hairymnstr/Z80-Project-Mark-2/doc/IMG00038-20100109-2210.jpg

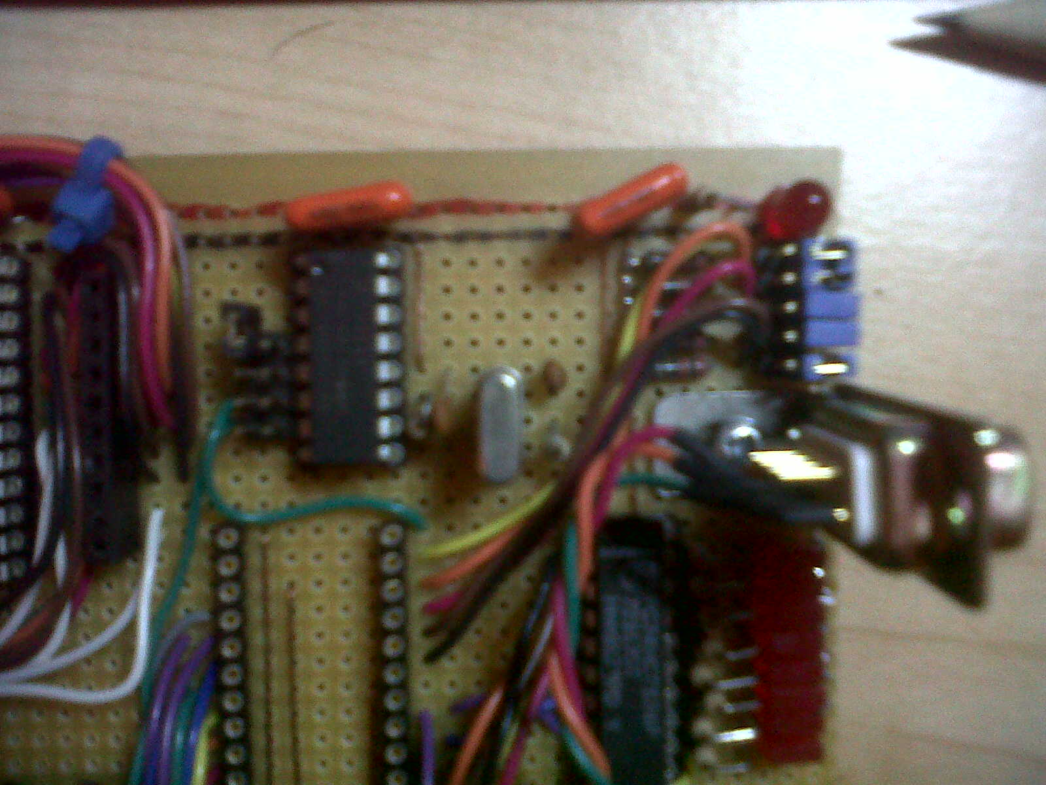
doc/IMG00038-20100109-2210.jpg
