hairymnstr/Z80-Project-Mark-2/doc/uart_jumpers.png

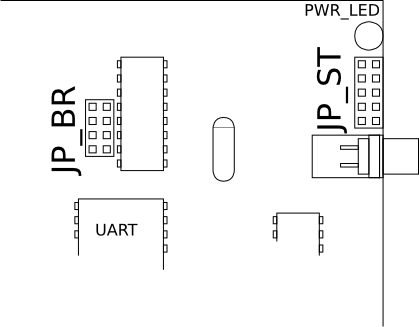
doc/uart_jumpers.png
