hairymnstr/Z80-Project-Mark-2/doc/pic_pinout.pdf

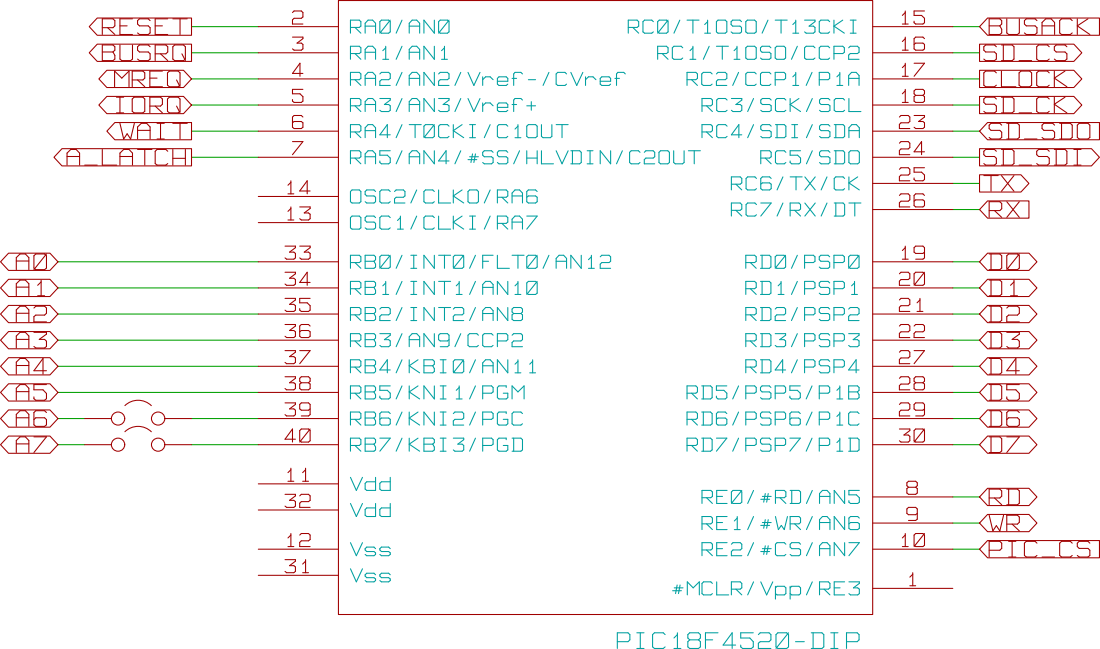
[picture p6: page 1]
