hairymnstr/Z80-Project-Mark-2/sch/z80_mark2-Interrupt Controller.pdf

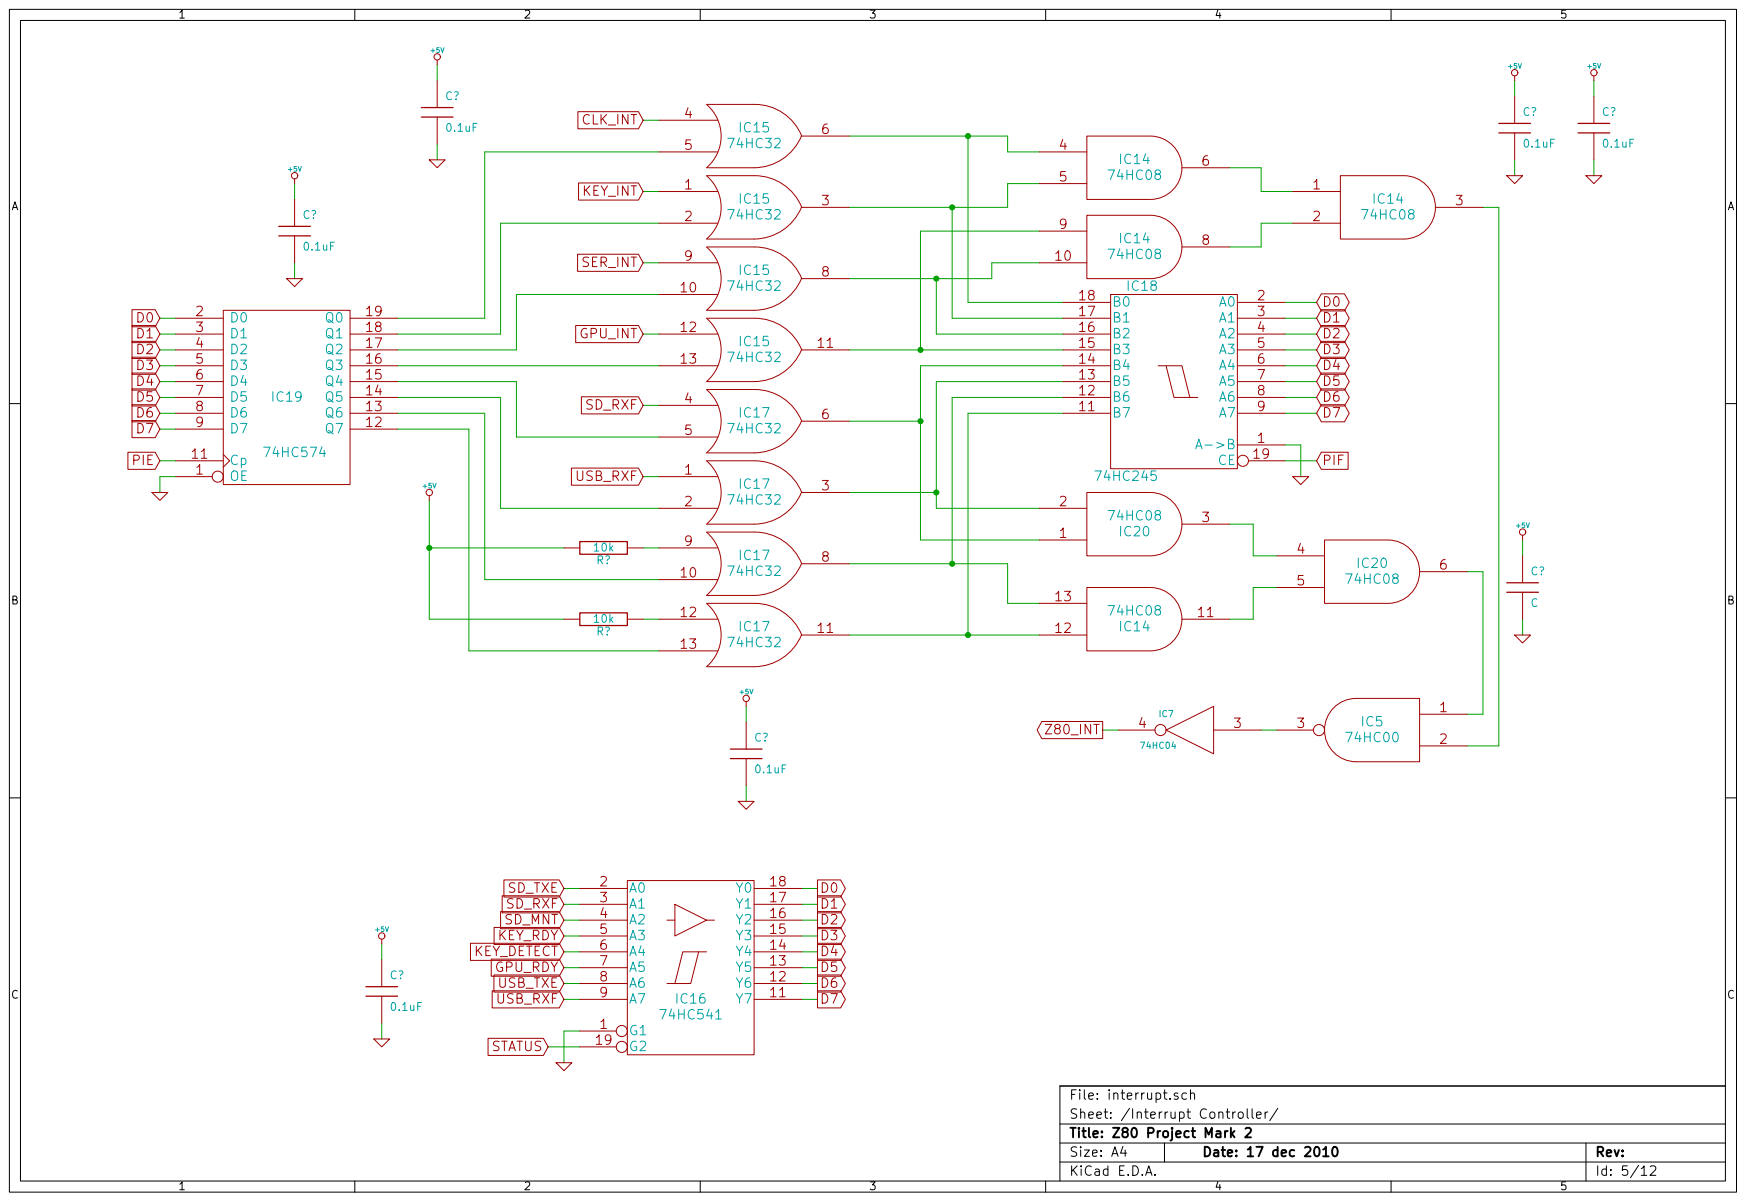
[picture p7: page 1]
