hairymnstr/Z80-Project-Mark-2/sch/z80_mark2-IO Decode.pdf

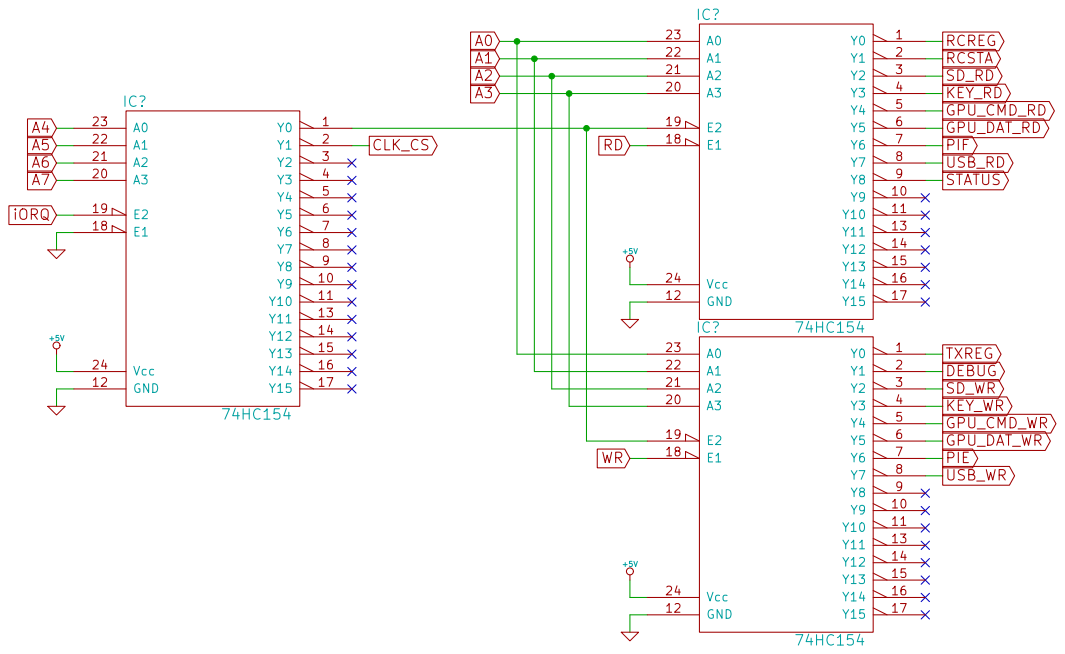
[picture p8: page 1]
