hairymnstr/Z80-Project-Mark-2/sch/z80_mark2-Keyboard PIC.pdf

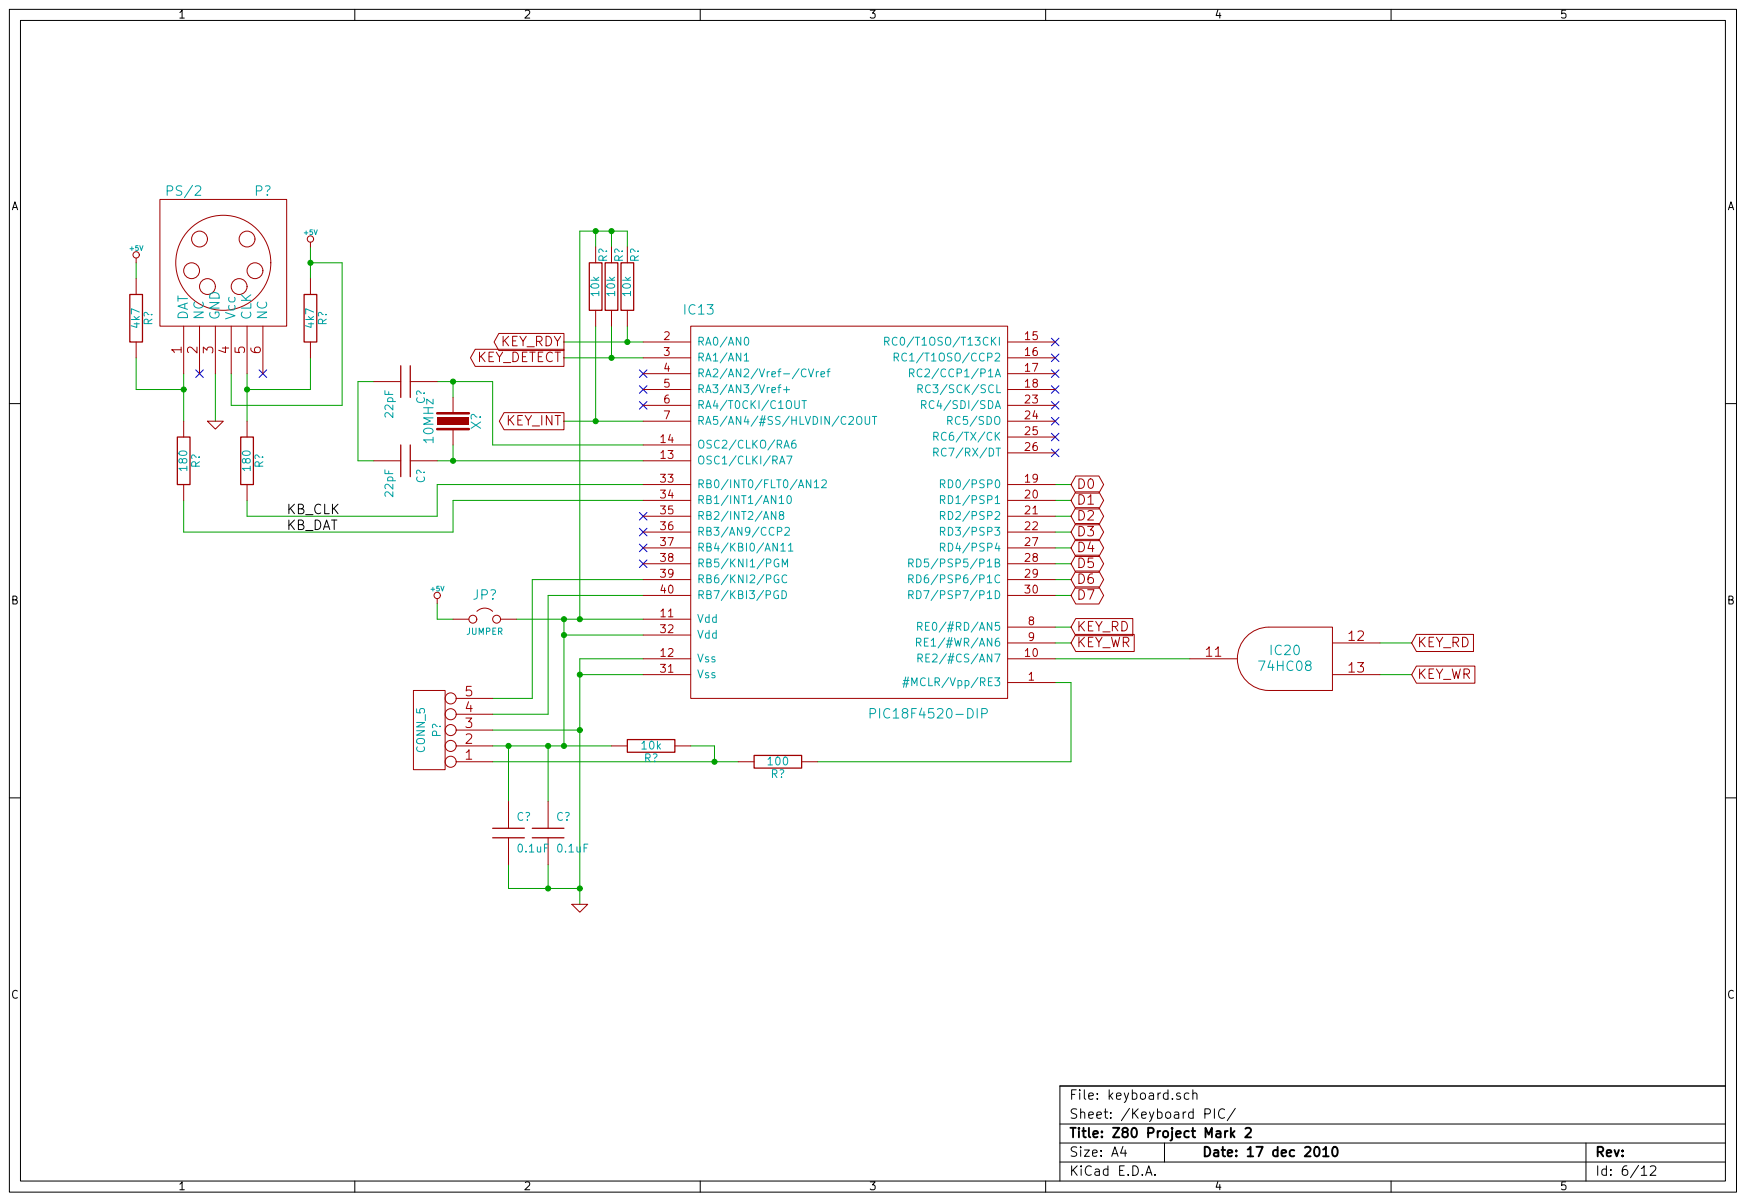
[picture p9: page 1]
