hairymnstr/Z80-Project-Mark-2/sch/z80_mark2-Master PIC.pdf

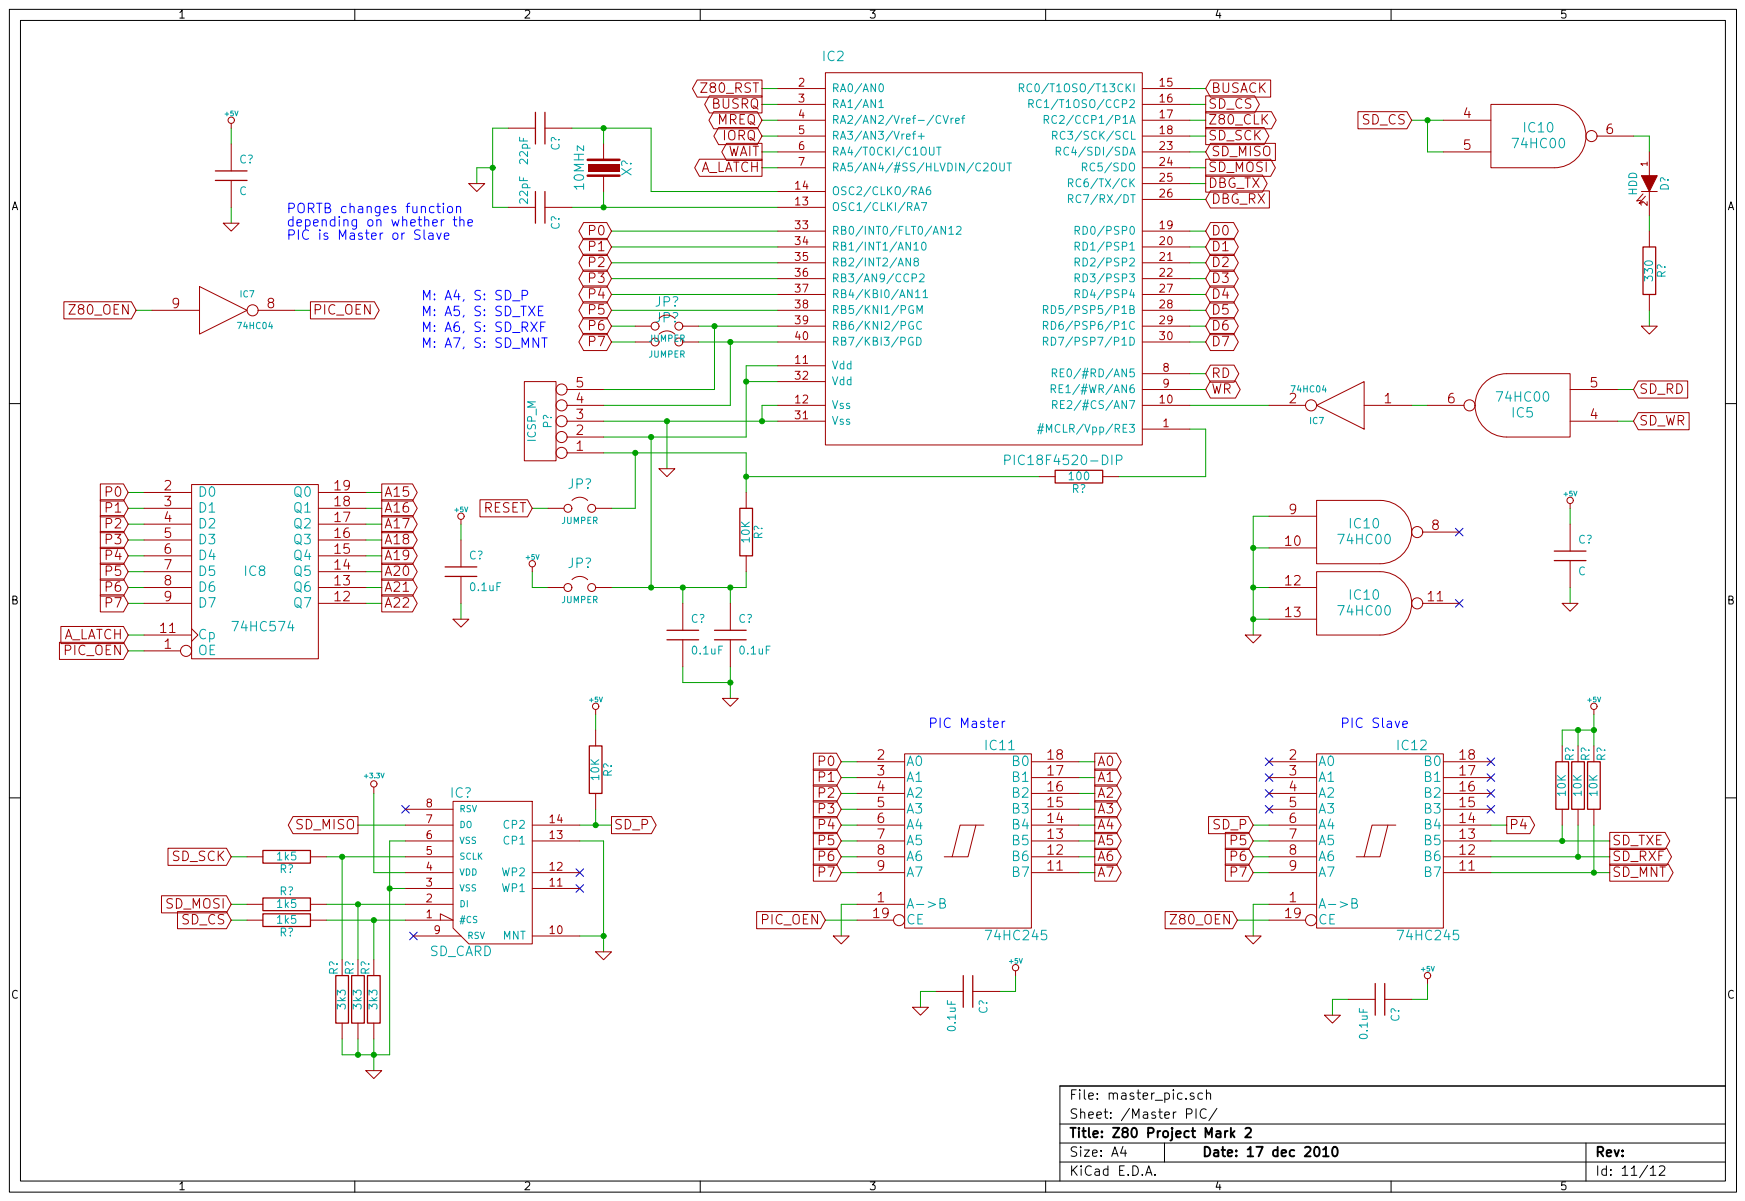
[picture p10: page 1]
