hairymnstr/Z80-Project-Mark-2/sch/z80_mark2-Memory.pdf

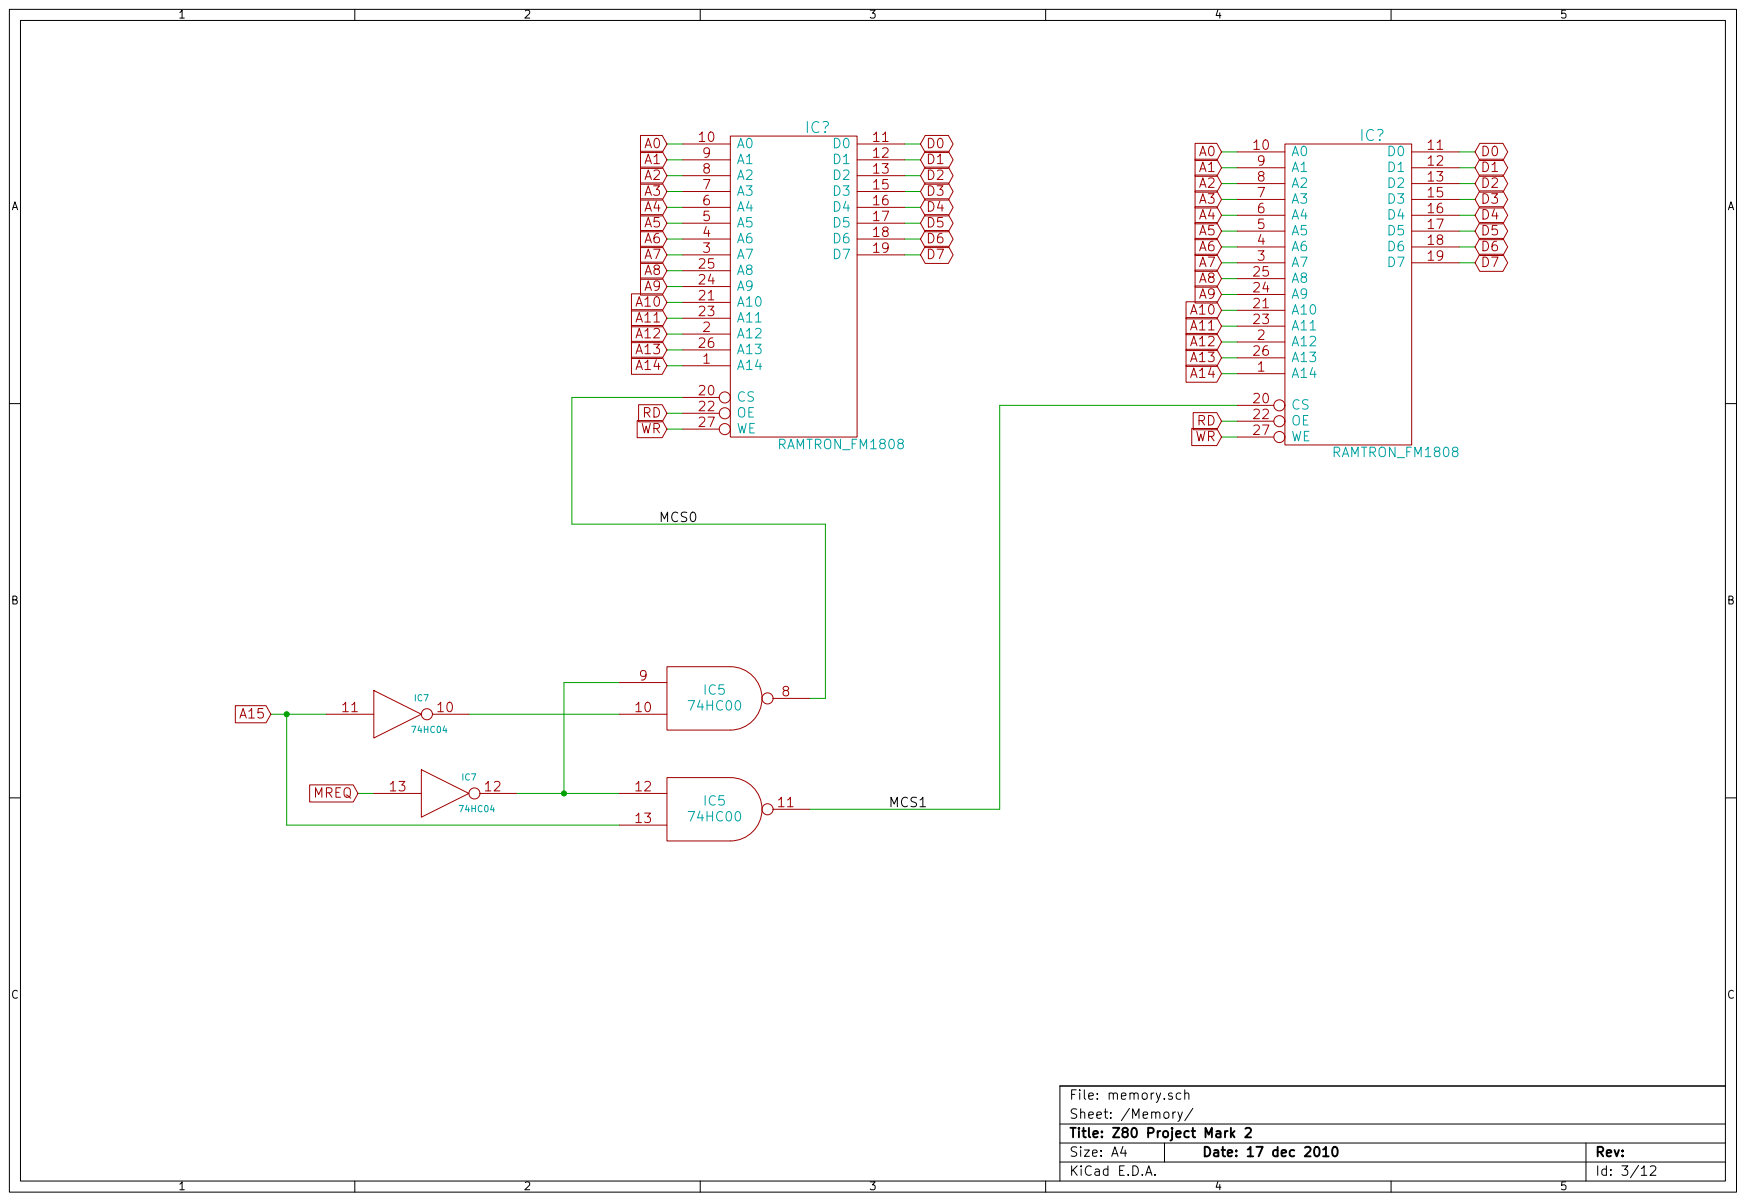
[picture p11: page 1]
