hairymnstr/Z80-Project-Mark-2/sch/z80_mark2-Memory2.pdf

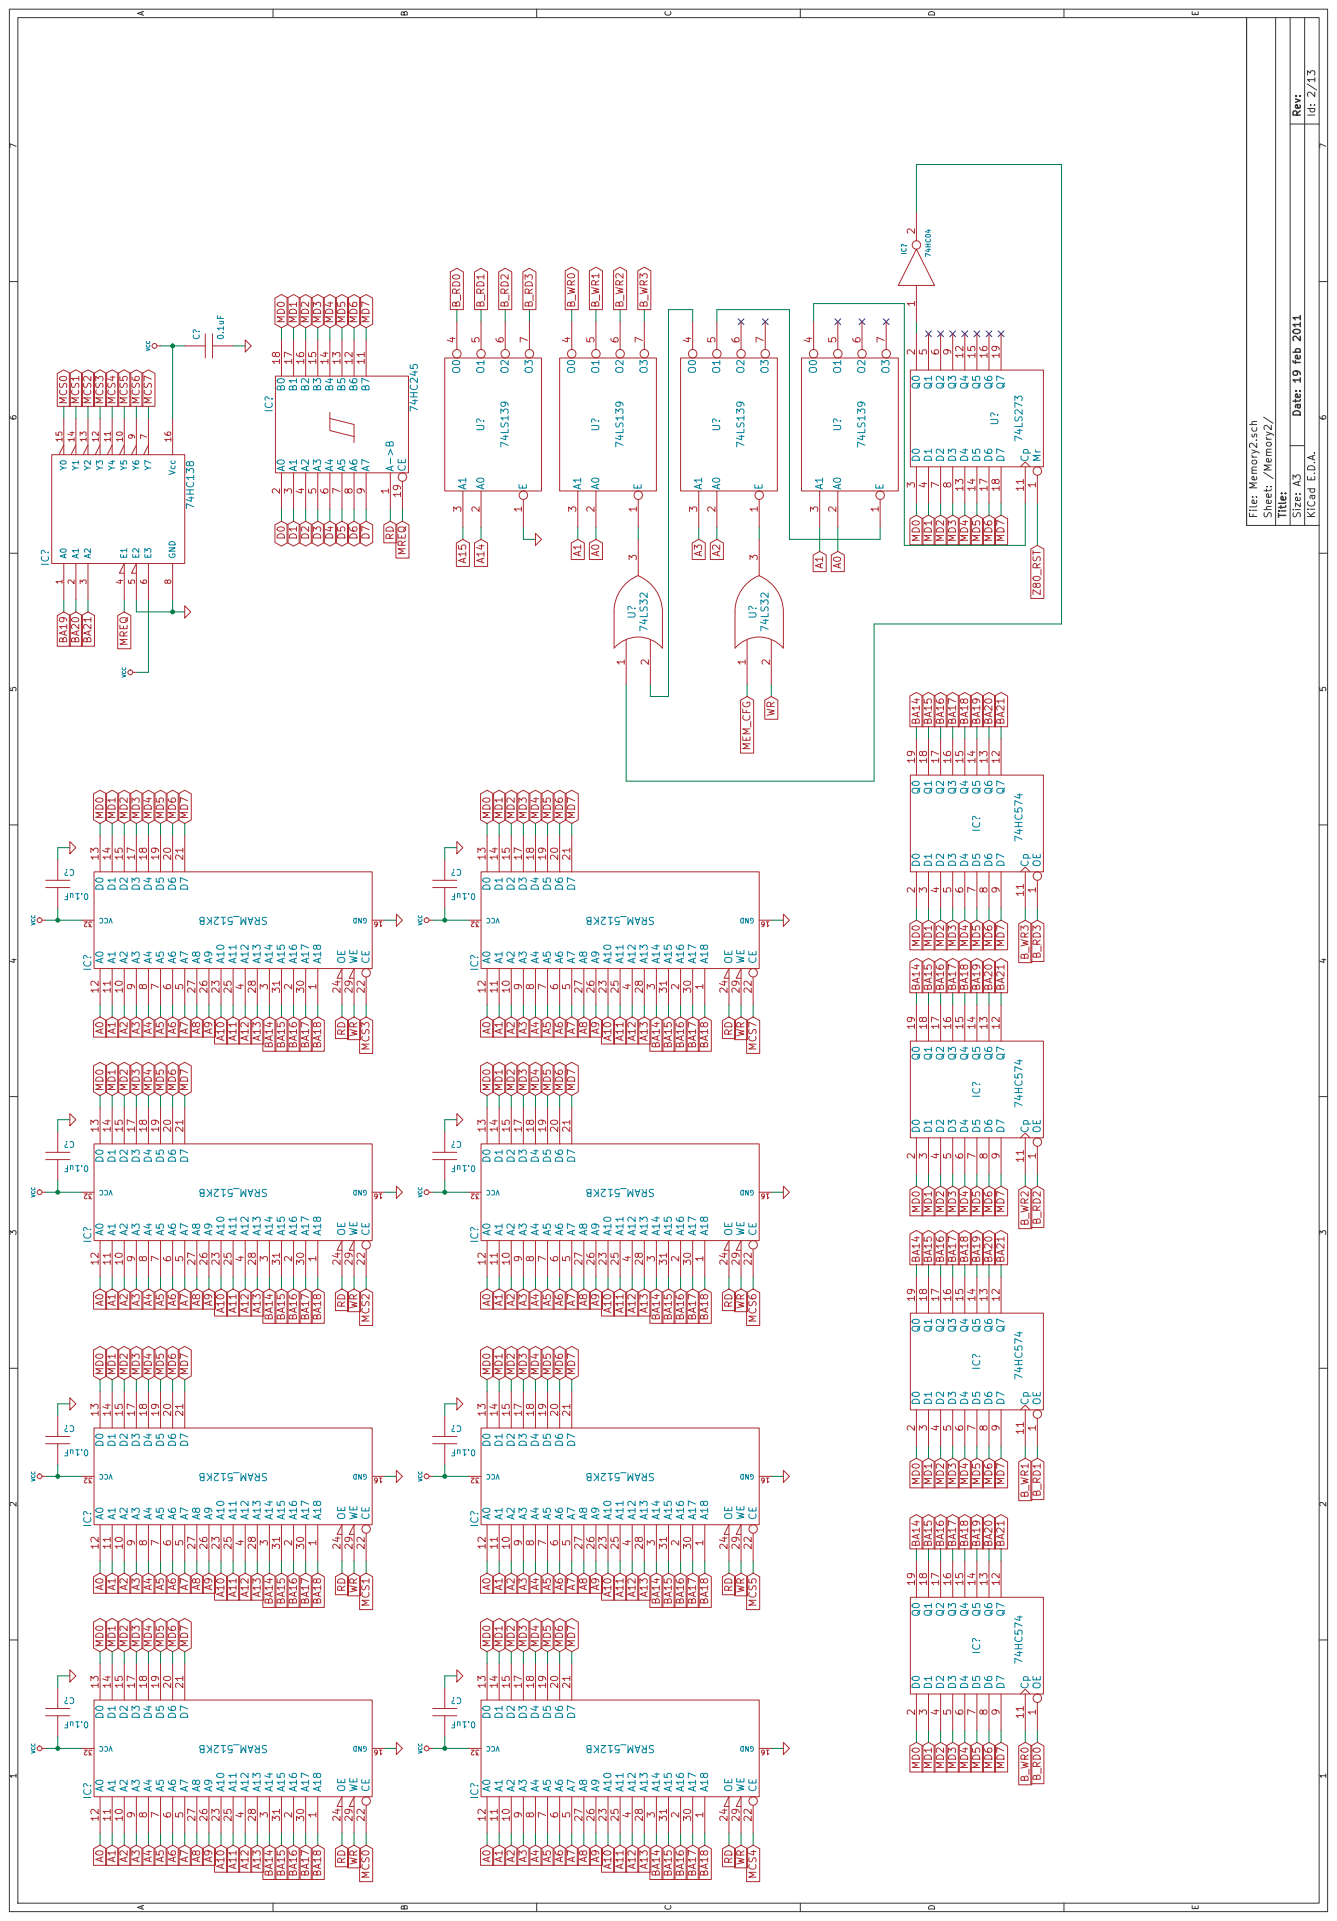
[picture p12: page 1]
