hairymnstr/Z80-Project-Mark-2/sch/z80_mark2-PSU.pdf

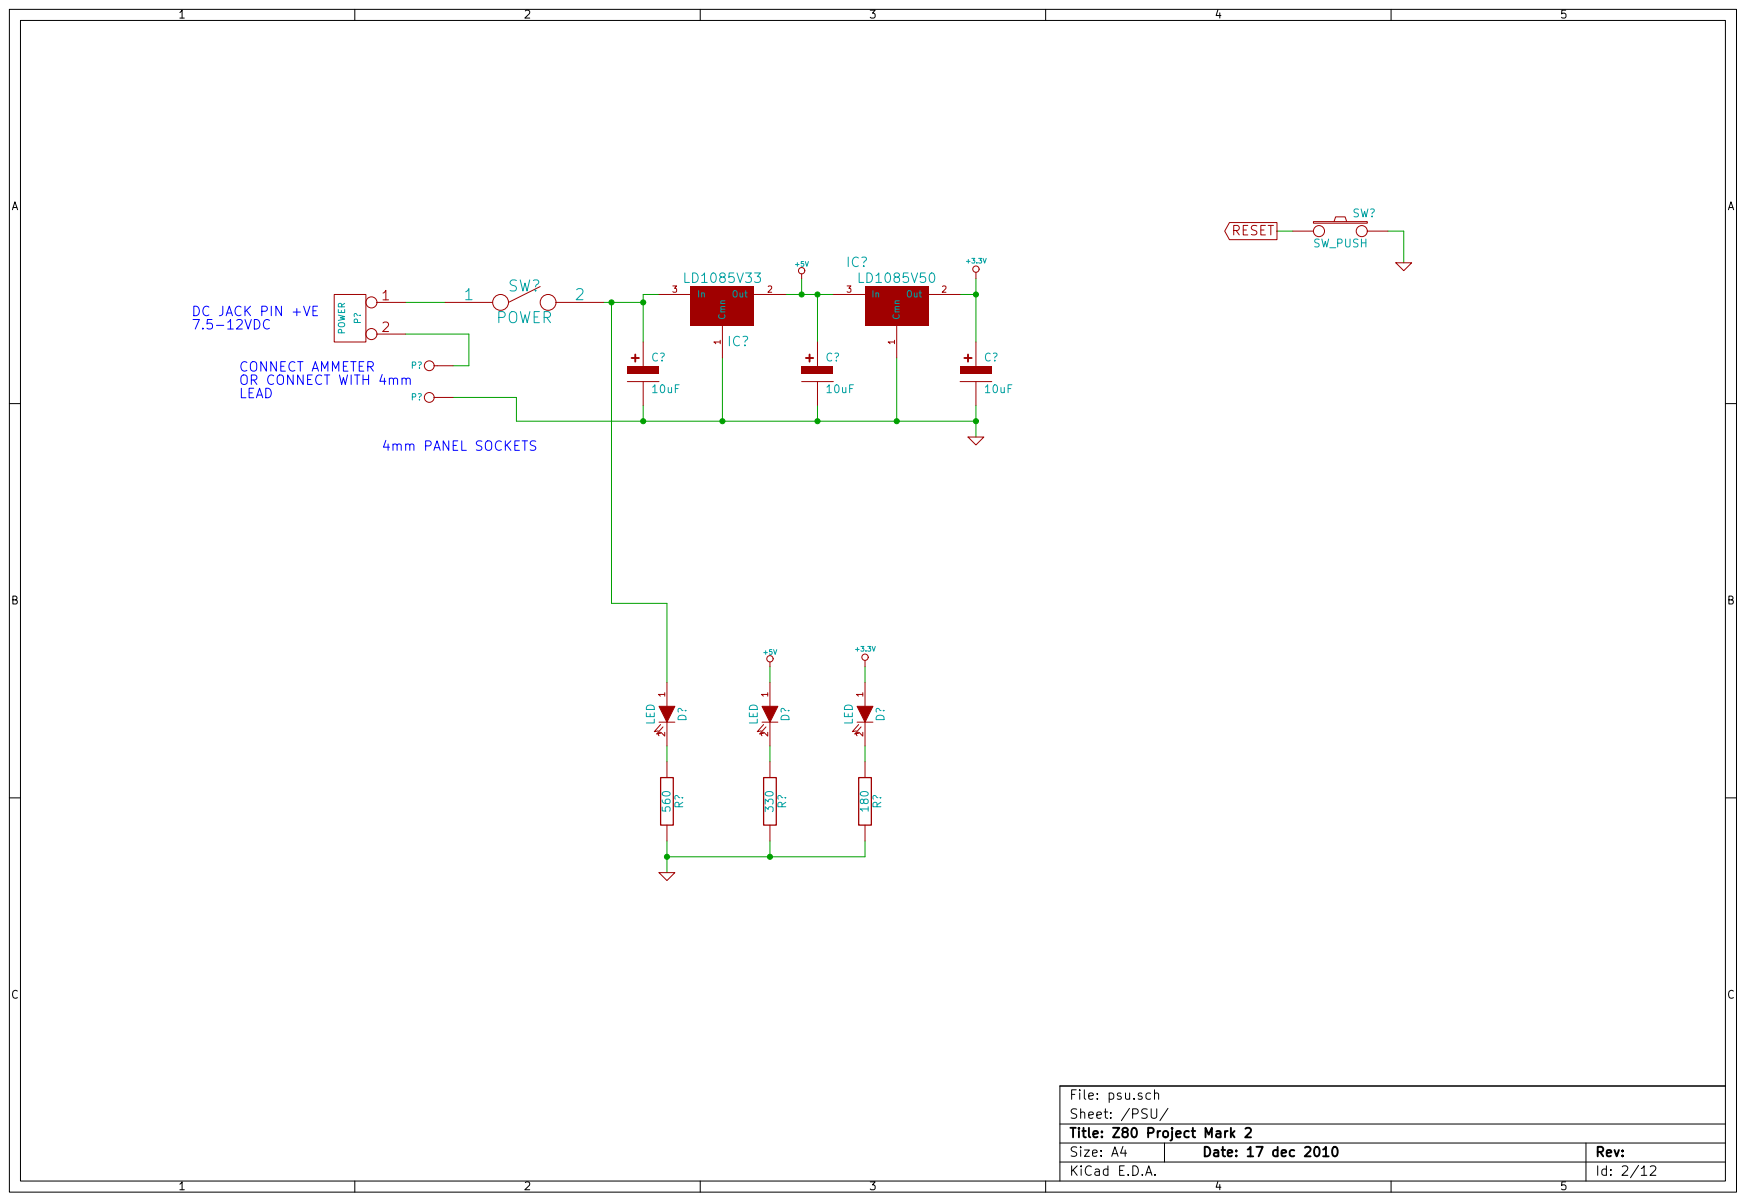
[picture p13: page 1]
