hairymnstr/Z80-Project-Mark-2/sch/z80_mark2-RTC.pdf

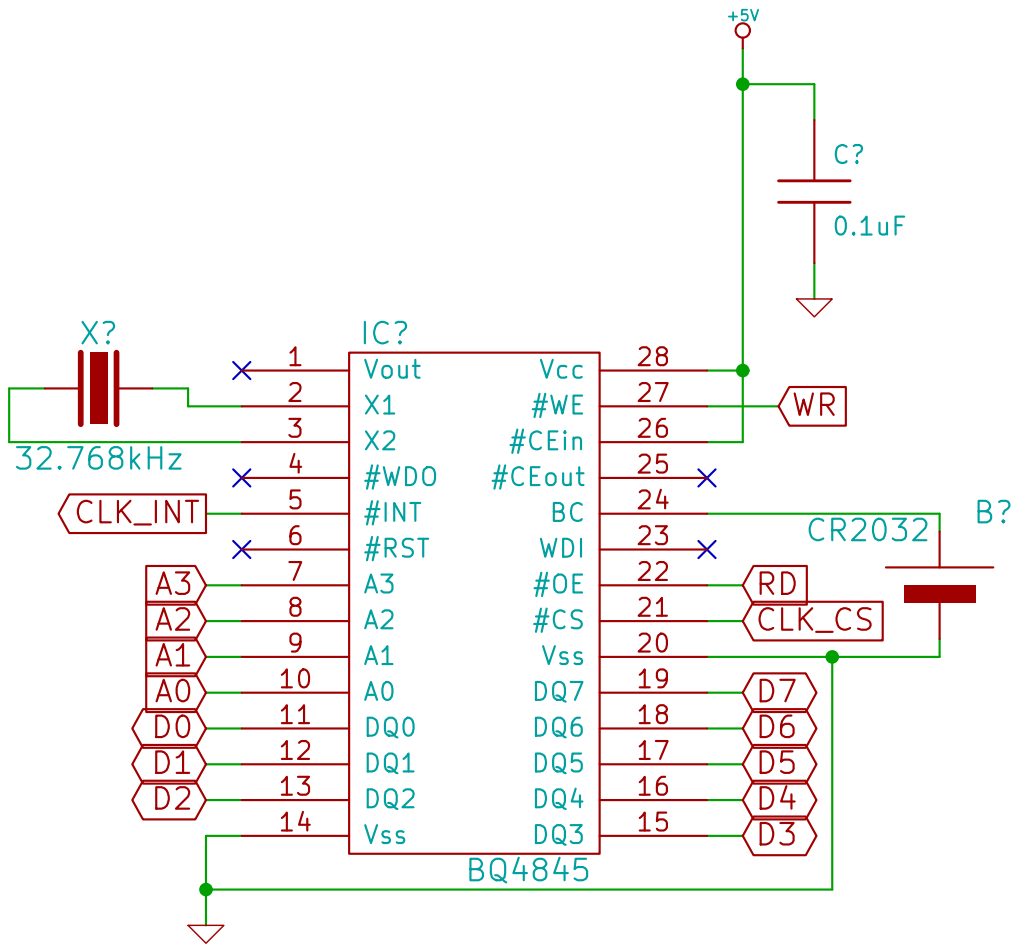
[picture p14: page 1]
