hairymnstr/Z80-Project-Mark-2/sch/z80_mark2-UART.pdf

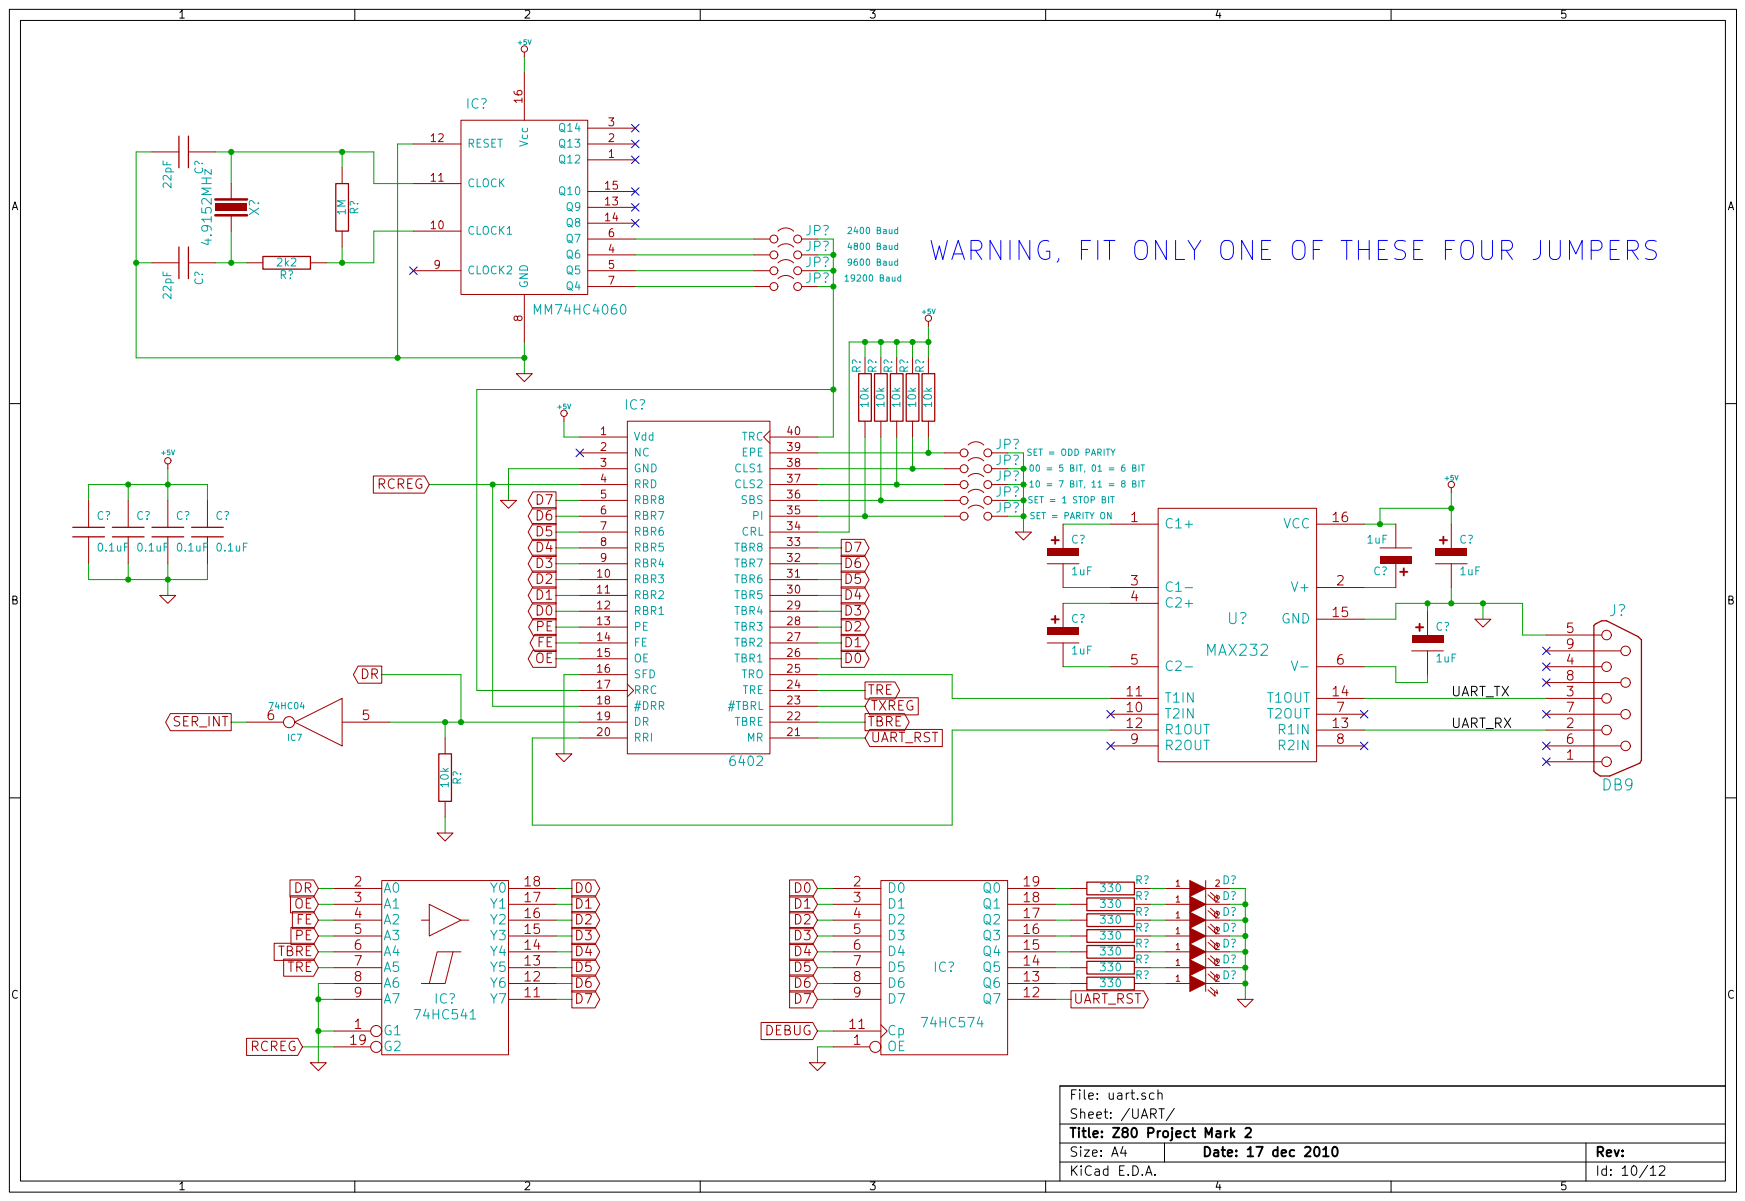
[picture p15: page 1]
