hairymnstr/Z80-Project-Mark-2/sch/z80_mark2-USB Host.pdf

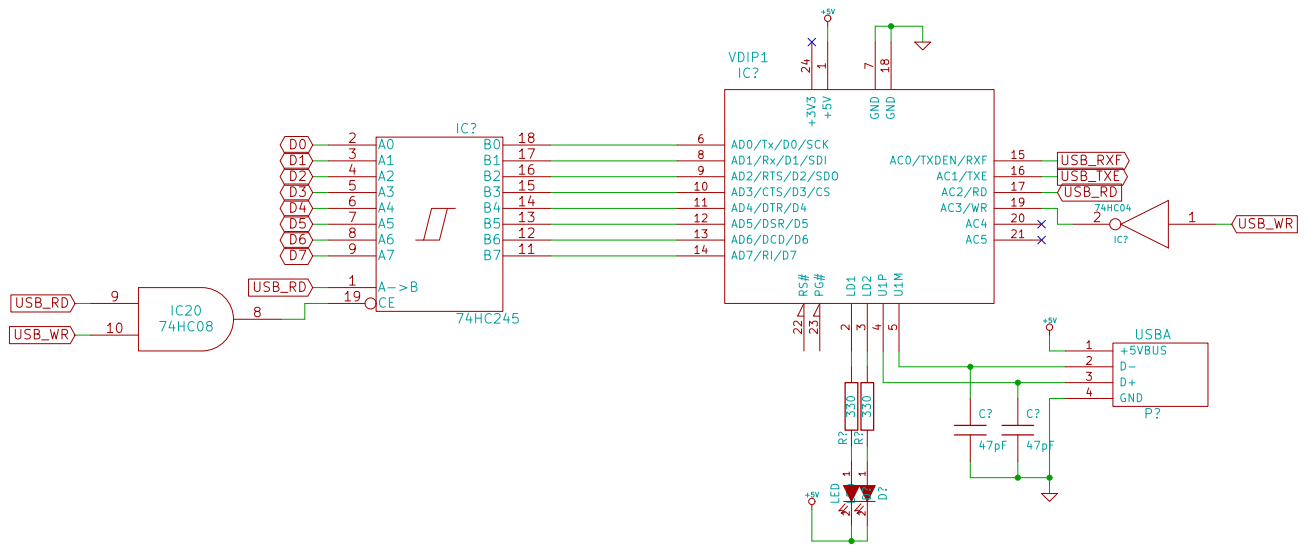
[picture p16: page 1]
