hairymnstr/Z80-Project-Mark-2/sch/z80_mark2-Video Driver.pdf

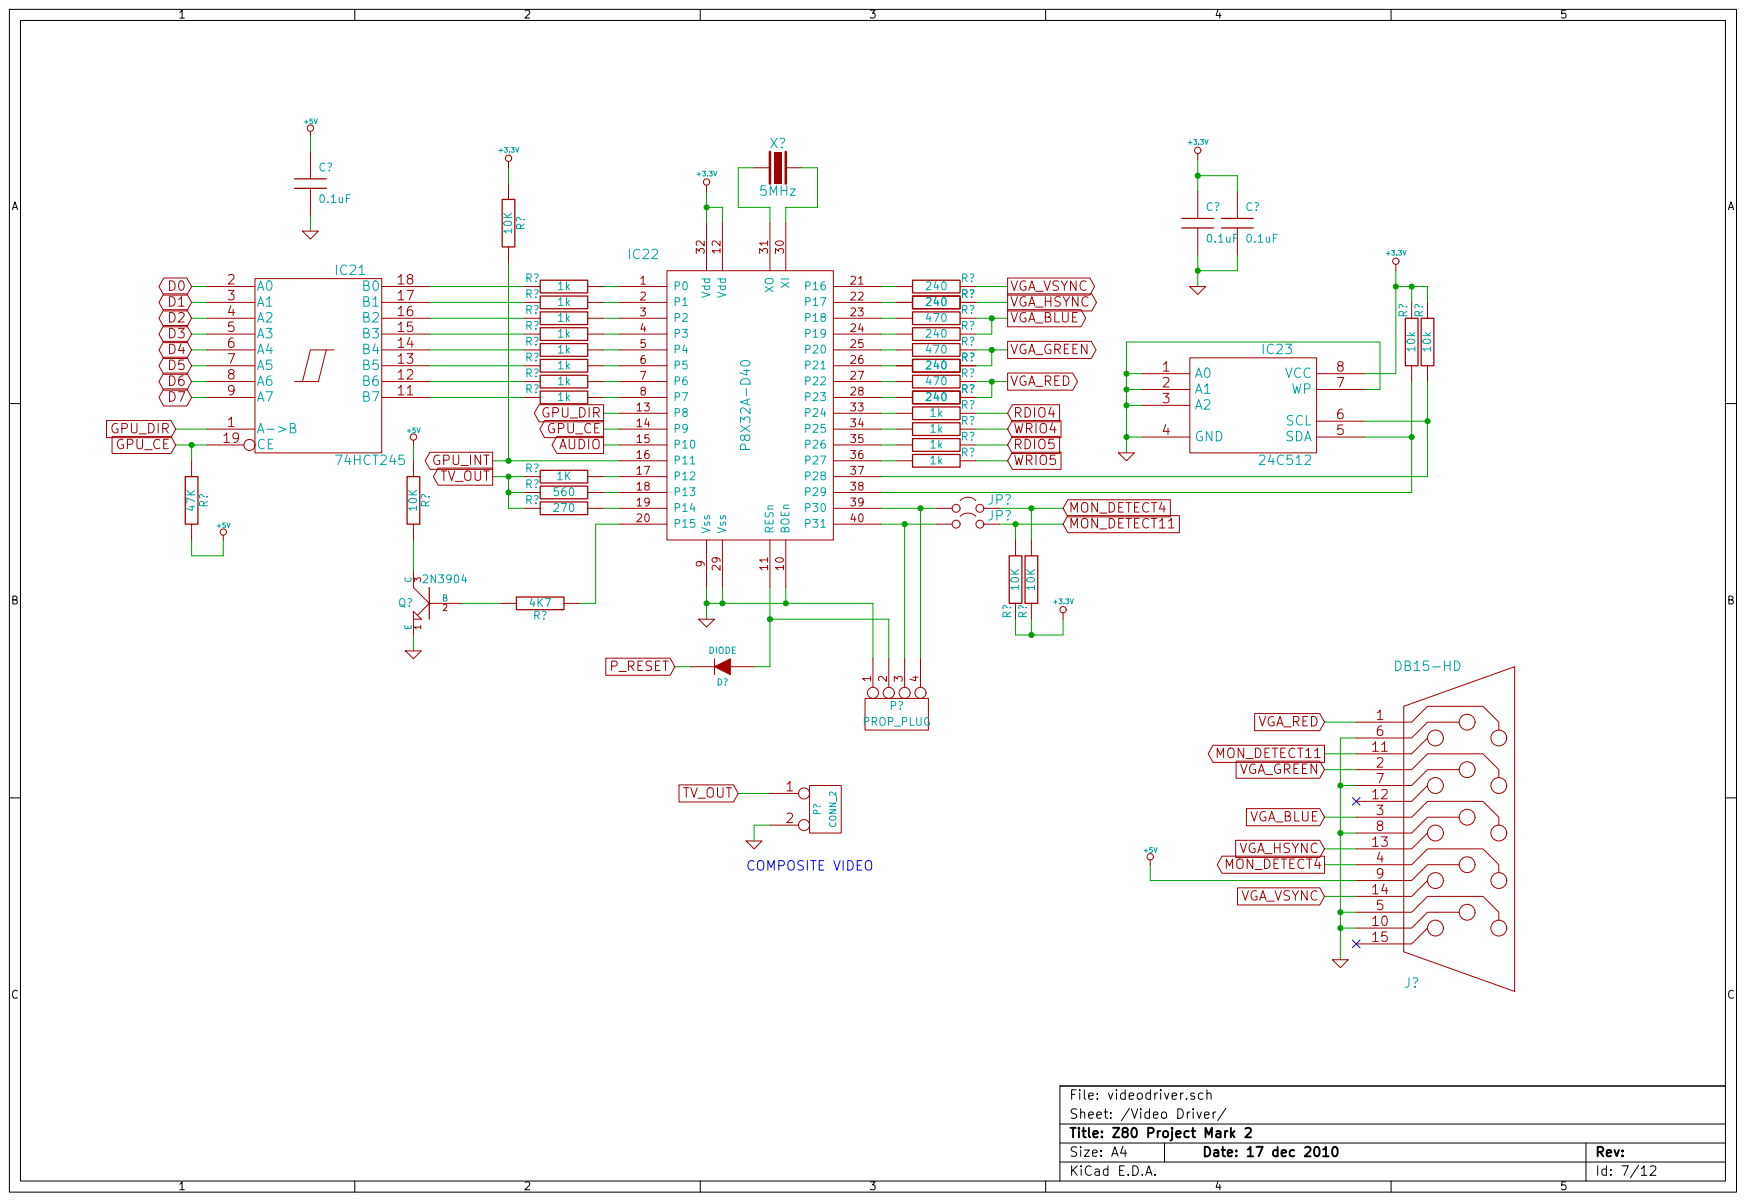
[picture p17: page 1]
