hairymnstr/Z80-Project-Mark-2/sch/z80_mark2-Z80.pdf

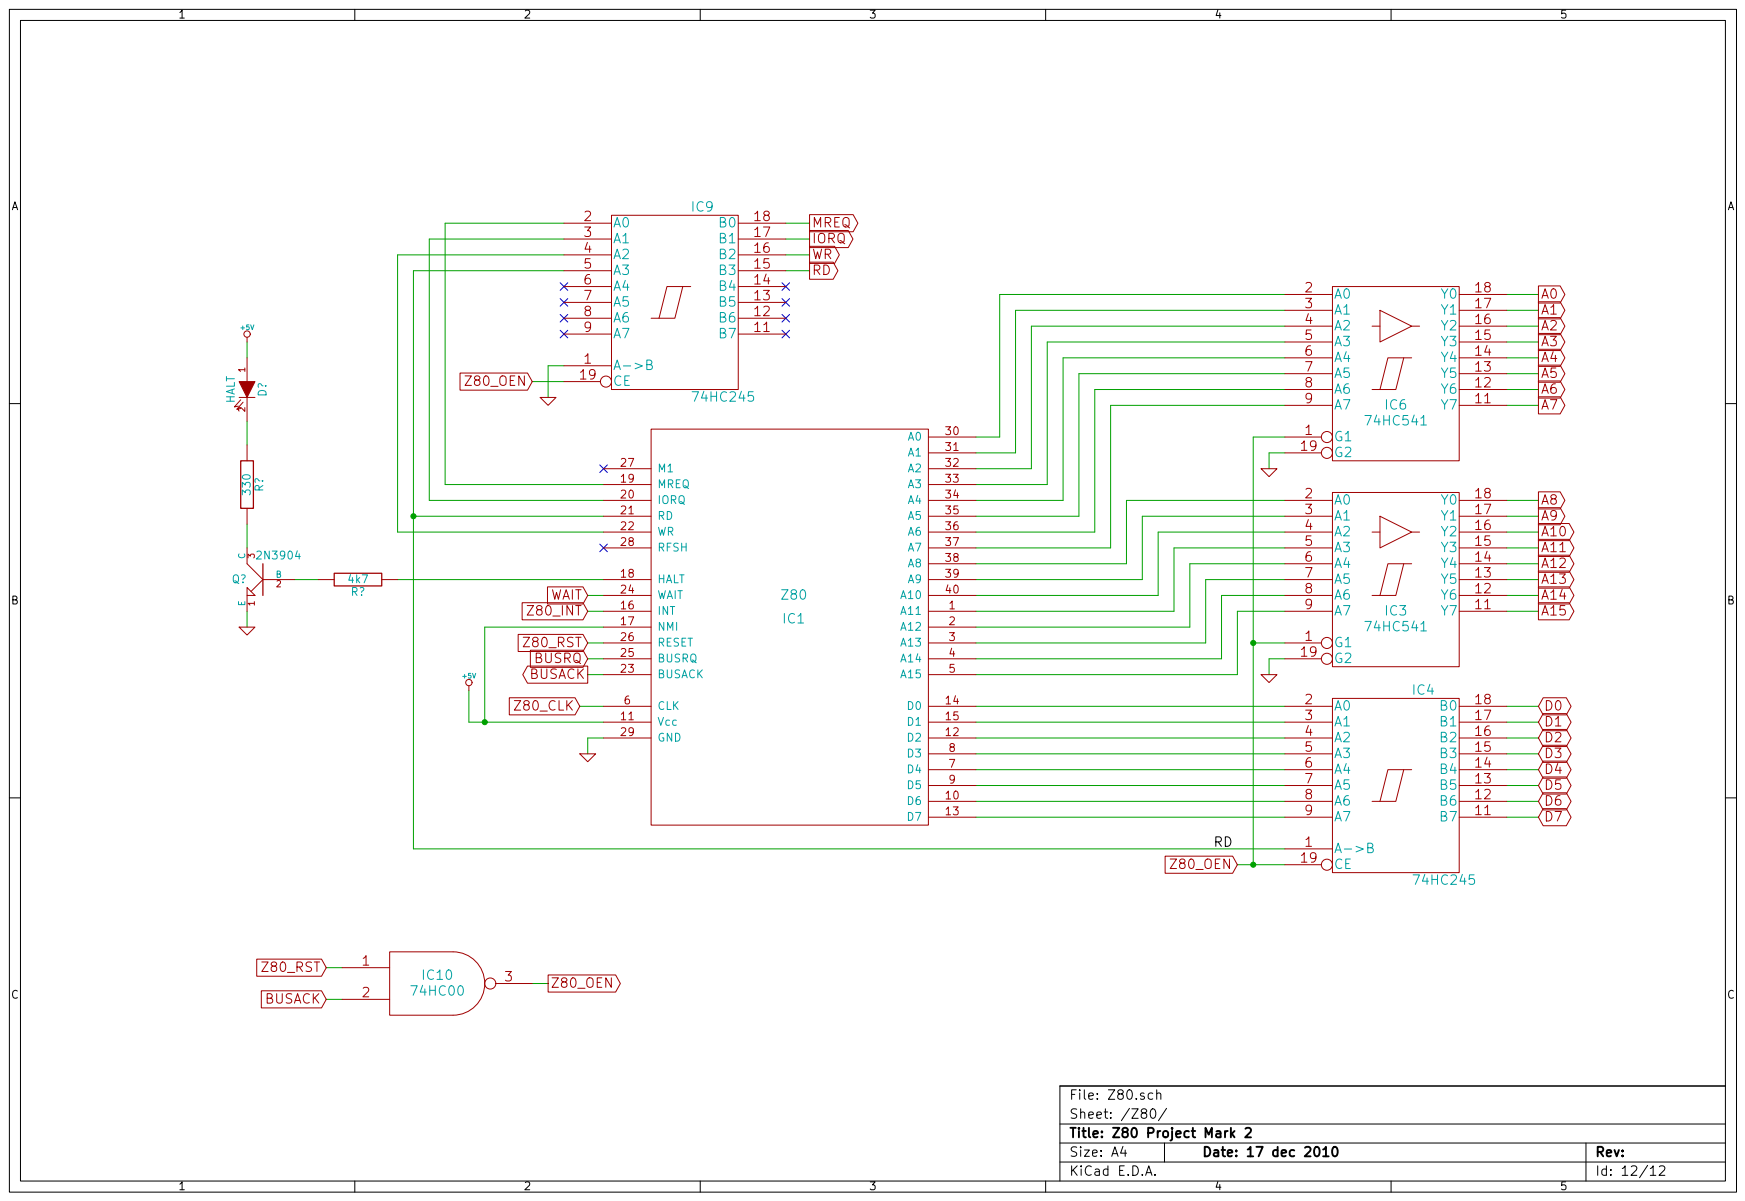
[picture p18: page 1]
