hairymnstr/Z80-Project-Mark-2/sch/z80_mark2.pdf

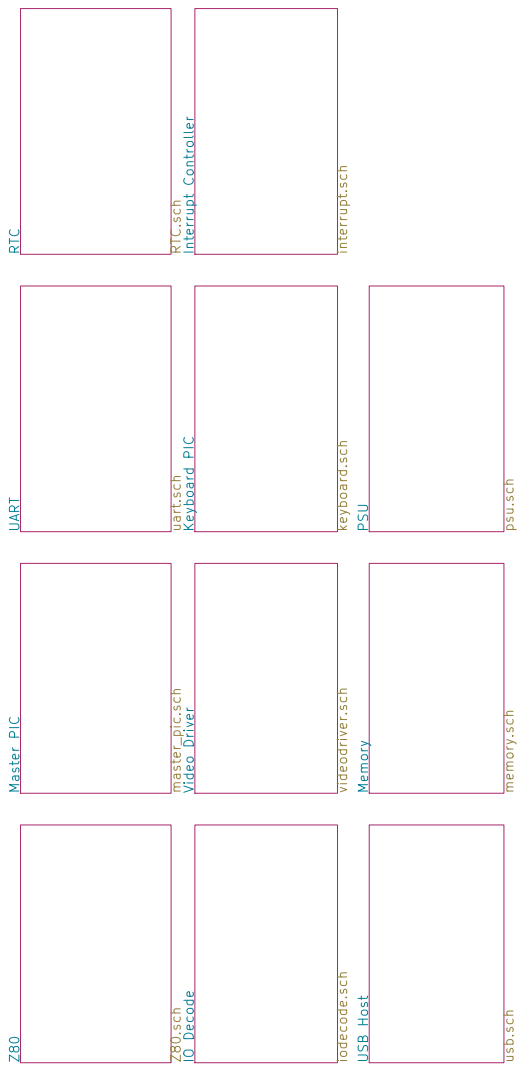
[picture p19: page 1]
