hairymnstr/Z80-Project-Mark-2/sch/Z80.sch

## KiCad design sch/Z80.sch (2011-03-06)

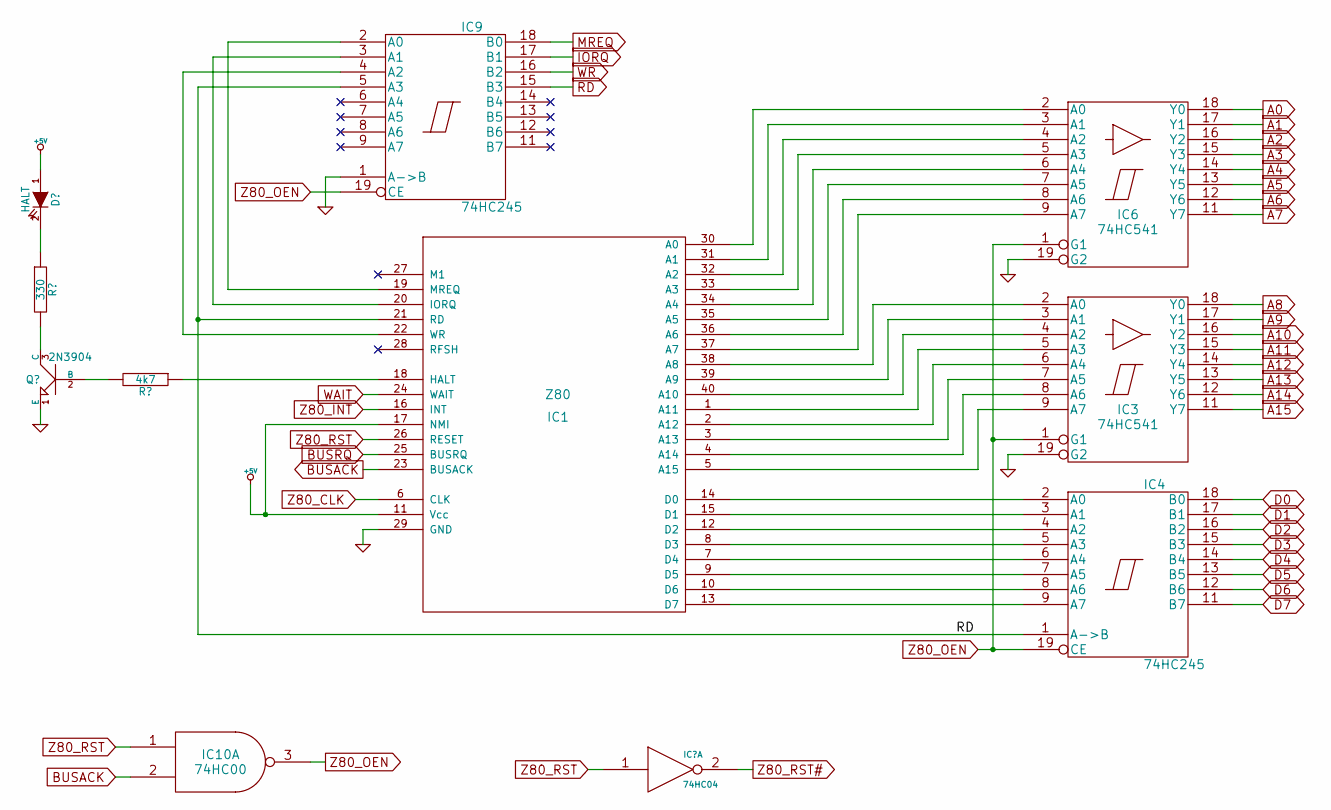
[picture p20: schematic Z80.sch]

Parts:
IC1: Z80
IC3, IC6: 74HC541; 108-5319
IC4, IC9: 74HC245; 108-5315
IC10: 74HC00

Connections:
+5V: IC1.11 (Vcc), IC1.17 (NMI)
A0: IC6.18 (Y0)
A1: IC6.17 (Y1)
A2: IC6.16 (Y2)
A3: IC6.15 (Y3)
A4: IC6.14 (Y4)
A5: IC6.13 (Y5)
A6: IC6.12 (Y6)
A7: IC6.11 (Y7)
A8: IC3.18 (Y0)
A9: IC3.17 (Y1)
A10: IC3.16 (Y2)
A11: IC3.15 (Y3)
A12: IC3.14 (Y4)
A13: IC3.13 (Y5)
A14: IC3.12 (Y6)
A15: IC3.11 (Y7)
BUSACK: IC1.23 (BUSACK), IC10.2
BUSRQ: IC1.25 (BUSRQ)
D0: IC4.18 (B0)
D1: IC4.17 (B1)
D2: IC4.16 (B2)
D3: IC4.15 (B3)
D4: IC4.14 (B4)
D5: IC4.13 (B5)
D6: IC4.12 (B6)
D7: IC4.11 (B7)
GND: IC1.29 (GND), IC3.19 (G2), IC6.19 (G2), IC9.1 (A->B)
IORQ: IC9.17 (B1)
MREQ: IC9.18 (B0)
unnamed: IC1.1 (A11), IC3.5 (A3)
unnamed: IC1.2 (A12), IC3.6 (A4)
unnamed: IC1.3 (A13), IC3.7 (A5)
unnamed: IC1.4 (A14), IC3.8 (A6)
unnamed: IC1.5 (A15), IC3.9 (A7)
unnamed: IC1.7 (D4), IC4.6 (A4)
unnamed: IC1.8 (D3), IC4.5 (A3)
unnamed: IC1.9 (D5), IC4.7 (A5)
unnamed: IC1.10 (D6), IC4.8 (A6)
unnamed: IC1.12 (D2), IC4.4 (A2)
unnamed: IC1.13 (D7), IC4.9 (A7)
unnamed: IC1.14 (D0), IC4.2 (A0)
unnamed: IC1.15 (D1), IC4.3 (A1)
unnamed: IC1.19 (MREQ), IC9.2 (A0)
unnamed: IC1.20 (IORQ), IC9.3 (A1)
unnamed: IC1.22 (WR), IC9.4 (A2)
unnamed: IC1.30 (A0), IC6.2 (A0)
unnamed: IC1.31 (A1), IC6.3 (A1)
unnamed: IC1.32 (A2), IC6.4 (A2)
unnamed: IC1.33 (A3), IC6.5 (A3)
unnamed: IC1.34 (A4), IC6.6 (A4)
unnamed: IC1.35 (A5), IC6.7 (A5)
unnamed: IC1.36 (A6), IC6.8 (A6)
unnamed: IC1.37 (A7), IC6.9 (A7)
unnamed: IC1.38 (A8), IC3.2 (A0)
unnamed: IC1.39 (A9), IC3.3 (A1)
unnamed: IC1.40 (A10), IC3.4 (A2)
RD: IC1.21 (RD), IC4.1 (A->B), IC9.5 (A3), IC9.15 (B3)
WAIT: IC1.24 (WAIT)
WR: IC9.16 (B2)
Z80_CLK: IC1.6 (CLK)
Z80_INT: IC1.16 (INT)
Z80_OEN: IC3.1 (G1), IC4.19 (CE), IC6.1 (G1), IC9.19 (CE), IC10.3
Z80_RST: IC1.26 (RESET), IC10.1
