hairymnstr/Z80-Project-Mark-2/sch/interrupt.sch

## KiCad design sch/interrupt.sch (2011-03-06)

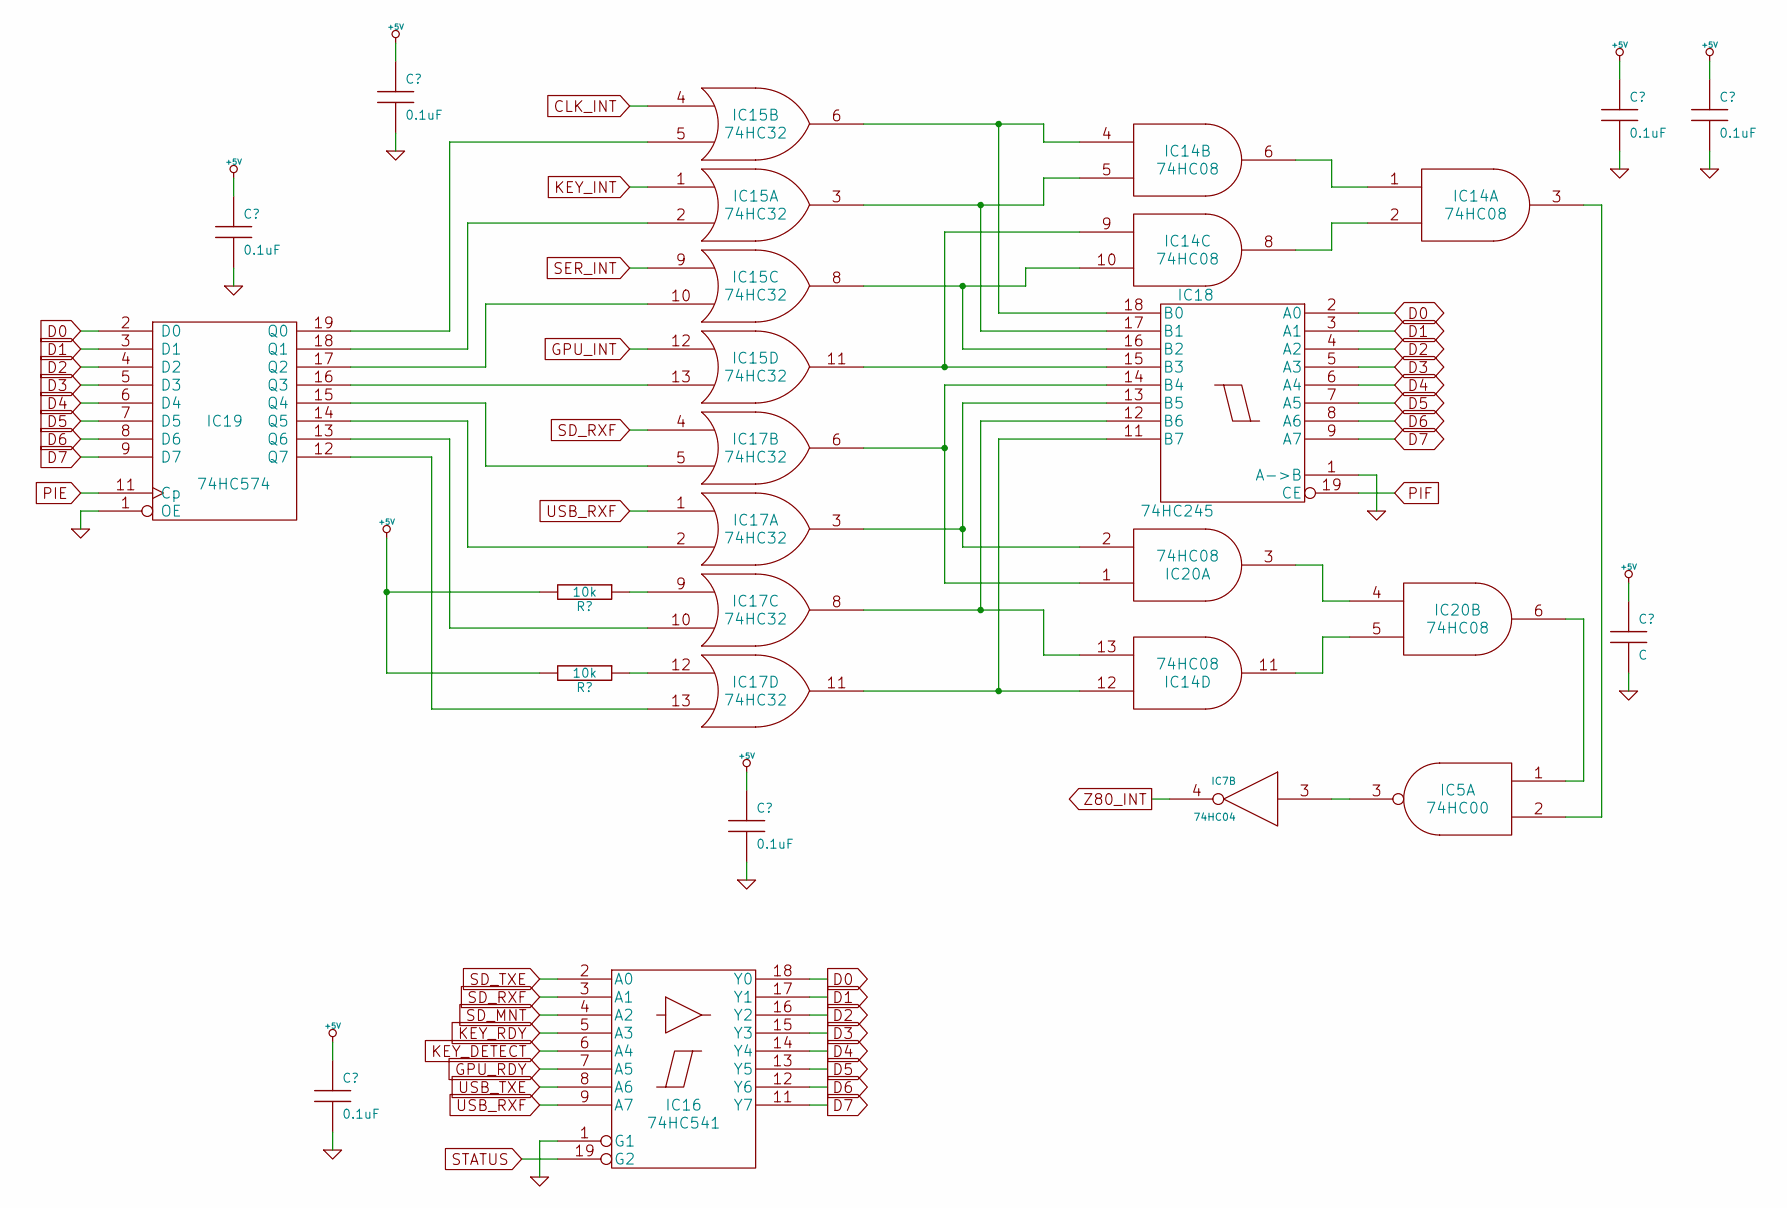
[picture p21: schematic interrupt.sch]

Parts:
IC5: 74HC00
IC7: 74HC04; 108-5299
IC14, IC20: 74HC08; 110-3129
IC15, IC17: 74HC32
IC16: 74HC541; 108-5319
IC18: 74HC245; 108-5315
IC19: 74HC574; 110-3146

Connections:
CLK_INT: IC15.4
D0: IC16.18 (Y0), IC18.2 (A0), IC19.2 (D0)
D1: IC16.17 (Y1), IC18.3 (A1), IC19.3 (D1)
D2: IC16.16 (Y2), IC18.4 (A2), IC19.4 (D2)
D3: IC16.15 (Y3), IC18.5 (A3), IC19.5 (D3)
D4: IC16.14 (Y4), IC18.6 (A4), IC19.6 (D4)
D5: IC16.13 (Y5), IC18.7 (A5), IC19.7 (D5)
D6: IC16.12 (Y6), IC18.8 (A6), IC19.8 (D6)
D7: IC16.11 (Y7), IC18.9 (A7), IC19.9 (D7)
GND: IC16.1 (G1), IC18.1 (A->B), IC19.1 (OE)
GPU_INT: IC15.12
GPU_RDY: IC16.7 (A5)
KEY_DETECT: IC16.6 (A4)
KEY_INT: IC15.1
KEY_RDY: IC16.5 (A3)
unnamed: IC5.3, IC7.3
unnamed: IC14.1, IC14.6
unnamed: IC14.2, IC14.8
unnamed: IC5.2, IC14.3
unnamed: IC14.4, IC15.6, IC18.18 (B0)
unnamed: IC14.5, IC15.3, IC18.17 (B1)
unnamed: IC14.9, IC15.11, IC18.15 (B3)
unnamed: IC14.10, IC15.8, IC18.16 (B2)
unnamed: IC14.11, IC20.5
unnamed: IC14.12, IC17.11, IC18.11 (B7)
unnamed: IC14.13, IC17.8, IC18.12 (B6)
unnamed: IC15.2, IC19.18 (Q1)
unnamed: IC15.5, IC19.19 (Q0)
unnamed: IC15.10, IC19.17 (Q2)
unnamed: IC15.13, IC19.16 (Q3)
unnamed: IC17.2, IC19.14 (Q5)
unnamed: IC17.3, IC18.13 (B5), IC20.2
unnamed: IC17.5, IC19.15 (Q4)
unnamed: IC17.6, IC18.14 (B4), IC20.1
unnamed: IC17.10, IC19.13 (Q6)
unnamed: IC17.13, IC19.12 (Q7)
unnamed: IC20.3, IC20.4
unnamed: IC5.1, IC20.6
PIE: IC19.11 (Cp)
PIF: IC18.19 (CE)
SD_MNT: IC16.4 (A2)
SD_RXF: IC16.3 (A1), IC17.4
SD_TXE: IC16.2 (A0)
SER_INT: IC15.9
STATUS: IC16.19 (G2)
USB_RXF: IC16.9 (A7), IC17.1
USB_TXE: IC16.8 (A6)
Z80_INT: IC7.4
