hairymnstr/Z80-Project-Mark-2/sch/keyboard.sch

## KiCad design sch/keyboard.sch (2011-03-06)

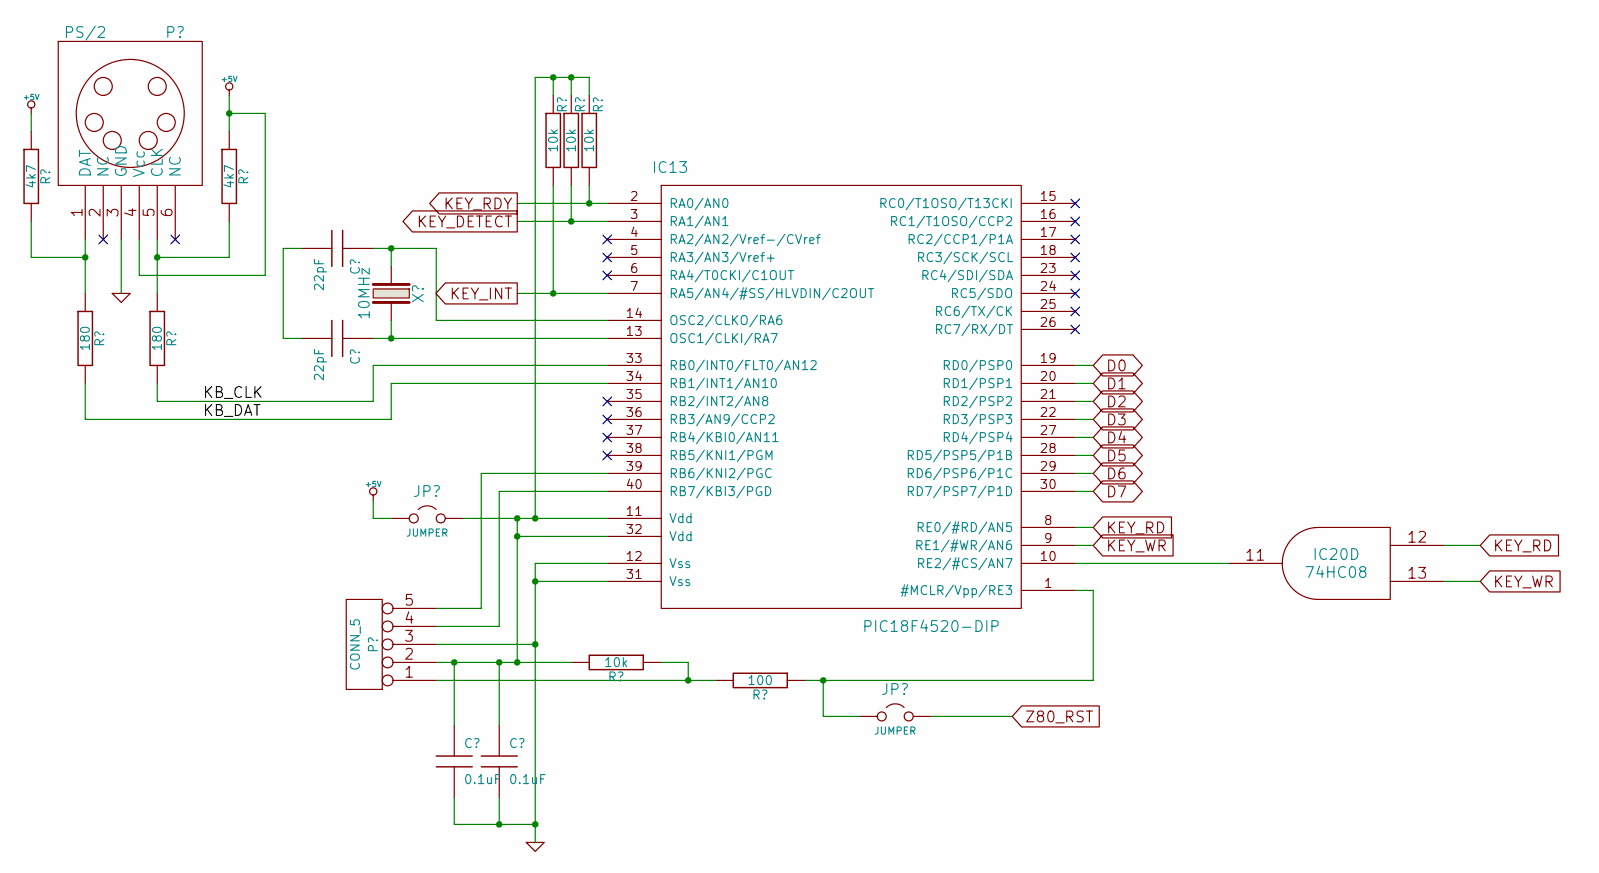
[picture p22: schematic keyboard.sch]

Parts:
IC13: PIC18F4520-DIP
IC20: 74HC08; 110-3129

Connections:
D0: IC13.19 (RD0/PSP0)
D1: IC13.20 (RD1/PSP1)
D2: IC13.21 (RD2/PSP2)
D3: IC13.22 (RD3/PSP3)
D4: IC13.27 (RD4/PSP4)
D5: IC13.28 (RD5/PSP5/P1B)
D6: IC13.29 (RD6/PSP6/P1C)
D7: IC13.30 (RD7/PSP7/P1D)
GND: IC13.12 (Vss), IC13.31 (Vss)
KB_CLK: IC13.33 (RB0/INT0/FLT0/AN12)
KB_DAT: IC13.34 (RB1/INT1/AN10)
KEY_DETECT: IC13.3 (RA1/AN1)
KEY_INT: IC13.7 (RA5/AN4/#SS/HLVDIN/C2OUT)
KEY_RD: IC13.8 (RE0/#RD/AN5), IC20.12
KEY_RDY: IC13.2 (RA0/AN0)
KEY_WR: IC13.9 (RE1/#WR/AN6), IC20.13
unnamed: IC13.10 (RE2/#CS/AN7), IC20.11
unnamed: IC13.11 (Vdd), IC13.32 (Vdd)
