hairymnstr/Z80-Project-Mark-2/sch/master_pic.sch

## KiCad design sch/master_pic.sch (2011-03-06)

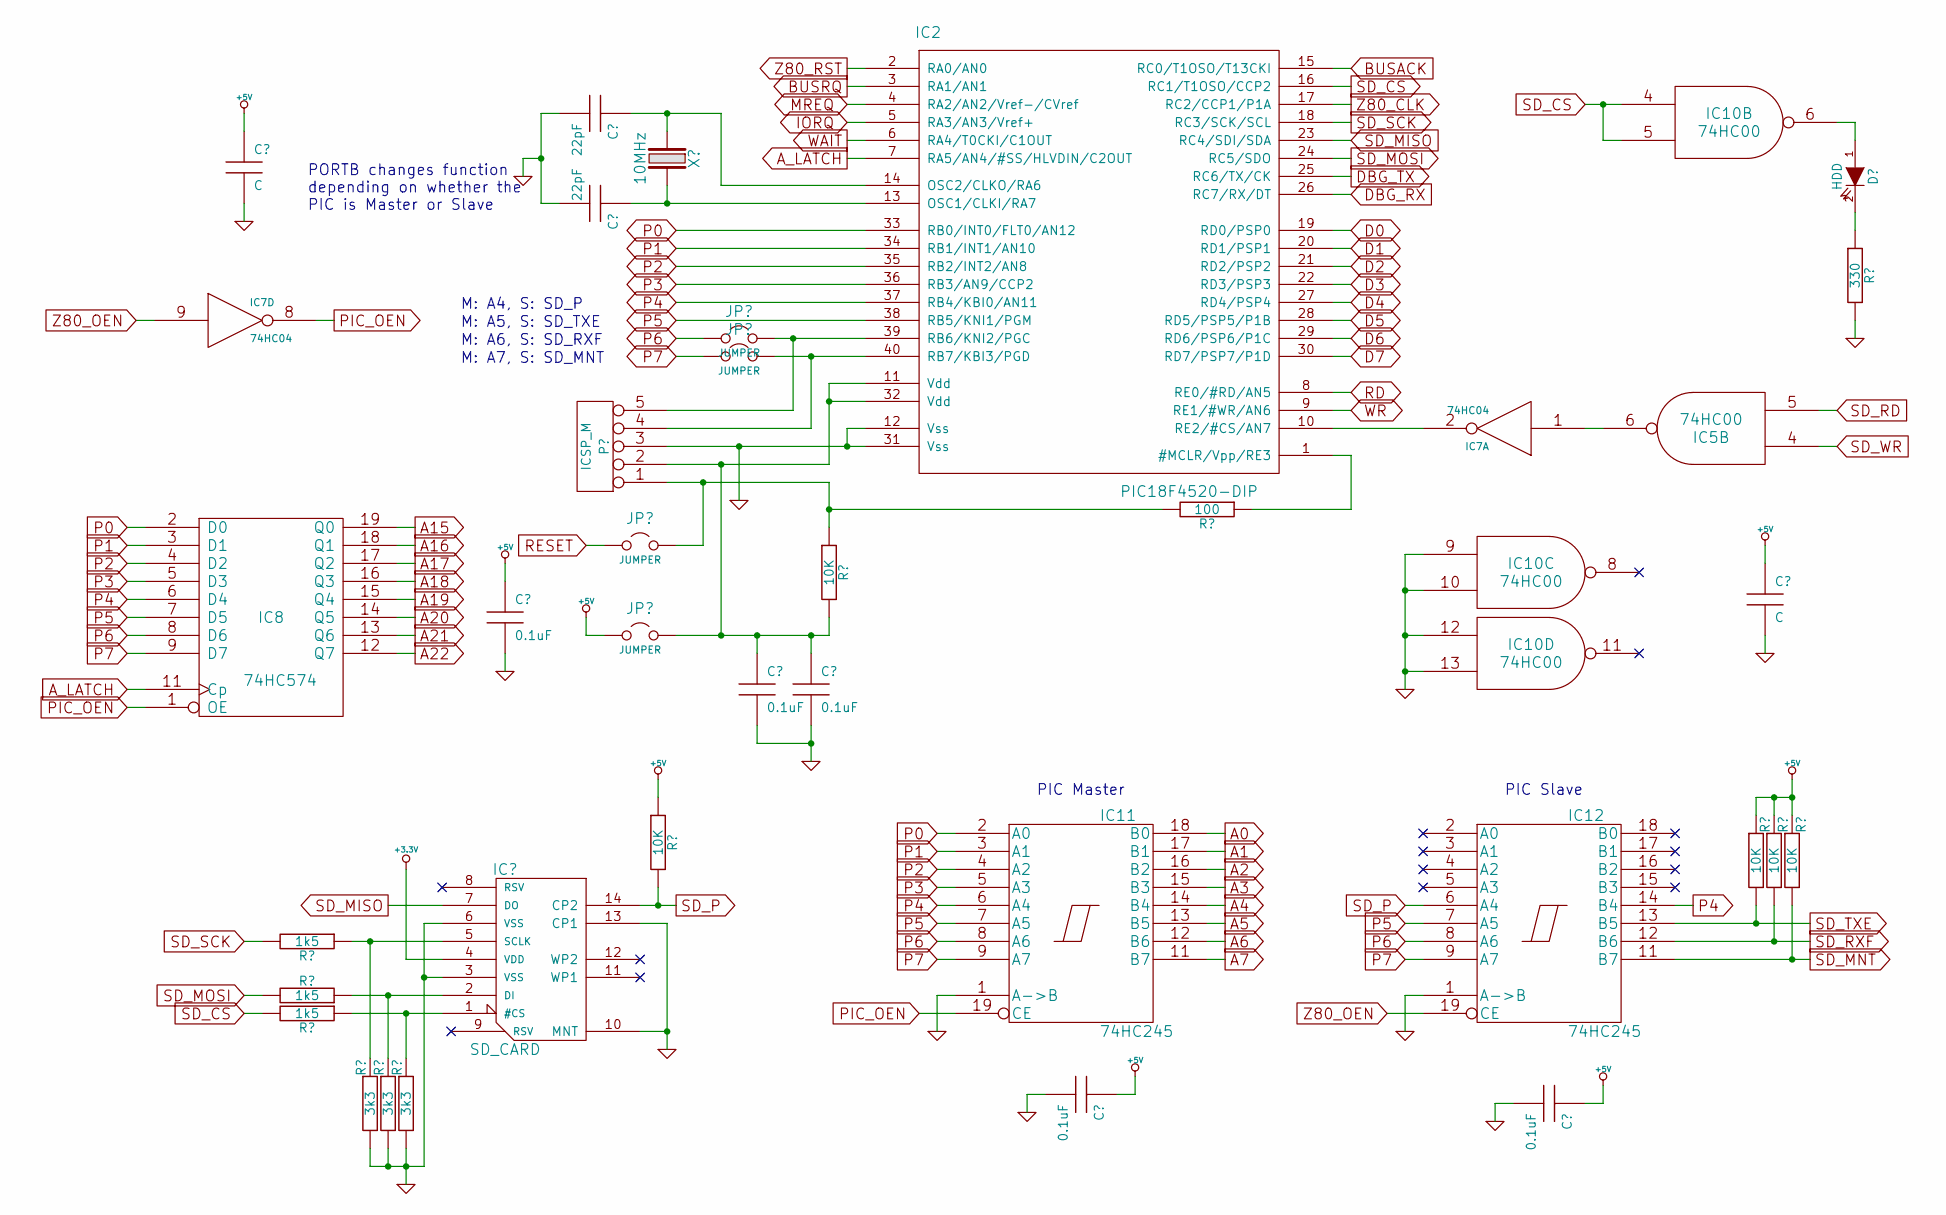
[picture p23: schematic master_pic.sch]

Parts:
IC2: PIC18F4520-DIP
IC5, IC10: 74HC00
IC7: 74HC04; 108-5299
IC8: 74HC574; 110-3146
IC11, IC12: 74HC245; 108-5315

Connections:
A0: IC11.18 (B0)
A1: IC11.17 (B1)
A2: IC11.16 (B2)
A3: IC11.15 (B3)
A4: IC11.14 (B4)
A5: IC11.13 (B5)
A6: IC11.12 (B6)
A7: IC11.11 (B7)
A15: IC8.19 (Q0)
A16: IC8.18 (Q1)
A17: IC8.17 (Q2)
A18: IC8.16 (Q3)
A19: IC8.15 (Q4)
A20: IC8.14 (Q5)
A21: IC8.13 (Q6)
A22: IC8.12 (Q7)
A_LATCH: IC2.7 (RA5/AN4/#SS/HLVDIN/C2OUT), IC8.11 (Cp)
BUSACK: IC2.15 (RC0/T1OSO/T13CKI)
BUSRQ: IC2.3 (RA1/AN1)
D0: IC2.19 (RD0/PSP0)
D1: IC2.20 (RD1/PSP1)
D2: IC2.21 (RD2/PSP2)
D3: IC2.22 (RD3/PSP3)
D4: IC2.27 (RD4/PSP4)
D5: IC2.28 (RD5/PSP5/P1B)
D6: IC2.29 (RD6/PSP6/P1C)
D7: IC2.30 (RD7/PSP7/P1D)
DBG_RX: IC2.26 (RC7/RX/DT)
DBG_TX: IC2.25 (RC6/TX/CK)
GND: IC2.12 (Vss), IC2.31 (Vss), IC10.9, IC10.10, IC10.12, IC10.13, IC11.1 (A->B), IC12.1 (A->B)
IORQ: IC2.5 (RA3/AN3/Vref+)
MREQ: IC2.4 (RA2/AN2/Vref-/CVref)
unnamed: IC2.10 (RE2/#CS/AN7), IC7.2
unnamed: IC2.11 (Vdd), IC2.32 (Vdd)
unnamed: IC5.6, IC7.1
P0: IC2.33 (RB0/INT0/FLT0/AN12), IC8.2 (D0), IC11.2 (A0)
P1: IC2.34 (RB1/INT1/AN10), IC8.3 (D1), IC11.3 (A1)
P2: IC2.35 (RB2/INT2/AN8), IC8.4 (D2), IC11.4 (A2)
P3: IC2.36 (RB3/AN9/CCP2), IC8.5 (D3), IC11.5 (A3)
P4: IC2.37 (RB4/KBI0/AN11), IC8.6 (D4), IC11.6 (A4), IC12.14 (B4)
P5: IC2.38 (RB5/KNI1/PGM), IC8.7 (D5), IC11.7 (A5), IC12.7 (A5)
P6: IC8.8 (D6), IC11.8 (A6), IC12.8 (A6)
P7: IC8.9 (D7), IC11.9 (A7), IC12.9 (A7)
PIC_OEN: IC7.8, IC8.1 (OE), IC11.19 (CE)
RD: IC2.8 (RE0/#RD/AN5)
SD_CS: IC2.16 (RC1/T1OSO/CCP2), IC10.4, IC10.5
SD_MISO: IC2.23 (RC4/SDI/SDA)
SD_MNT: IC12.11 (B7)
SD_MOSI: IC2.24 (RC5/SDO)
SD_P: IC12.6 (A4)
SD_RD: IC5.5
SD_RXF: IC12.12 (B6)
SD_SCK: IC2.18 (RC3/SCK/SCL)
SD_TXE: IC12.13 (B5)
SD_WR: IC5.4
WAIT: IC2.6 (RA4/T0CKI/C1OUT)
WR: IC2.9 (RE1/#WR/AN6)
Z80_CLK: IC2.17 (RC2/CCP1/P1A)
Z80_OEN: IC7.9, IC12.19 (CE)
Z80_RST: IC2.2 (RA0/AN0)

Notes on the sheet:
PIC Master
PIC Slave
PORTB changes function depending on whether the PIC is Master or Slave
M: A7, S: SD_MNT
M: A6, S: SD_RXF
M: A5, S: SD_TXE
M: A4, S: SD_P
