hairymnstr/Z80-Project-Mark-2/sch/memory.sch

## KiCad design sch/memory.sch (2011-03-06)

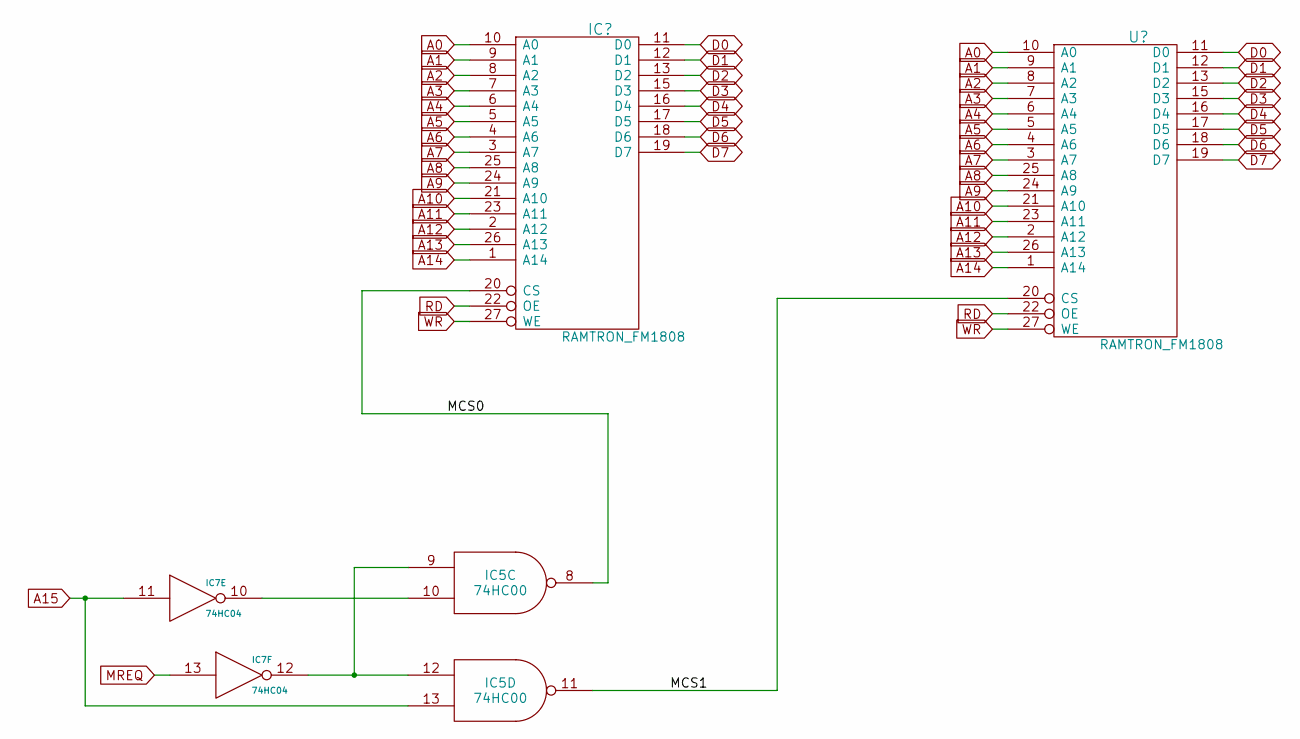
[picture p24: schematic memory.sch]

Parts:
IC5: 74HC00
IC7: 74HC04; 108-5299

Connections:
A15: IC5.13, IC7.11
MCS0: IC5.8
MCS1: IC5.11
MREQ: IC7.13
unnamed: IC5.10, IC7.10
unnamed: IC5.9, IC5.12, IC7.12
