hairymnstr/Z80-Project-Mark-2/sch/videodriver.sch

## KiCad design sch/videodriver.sch (2011-03-06)

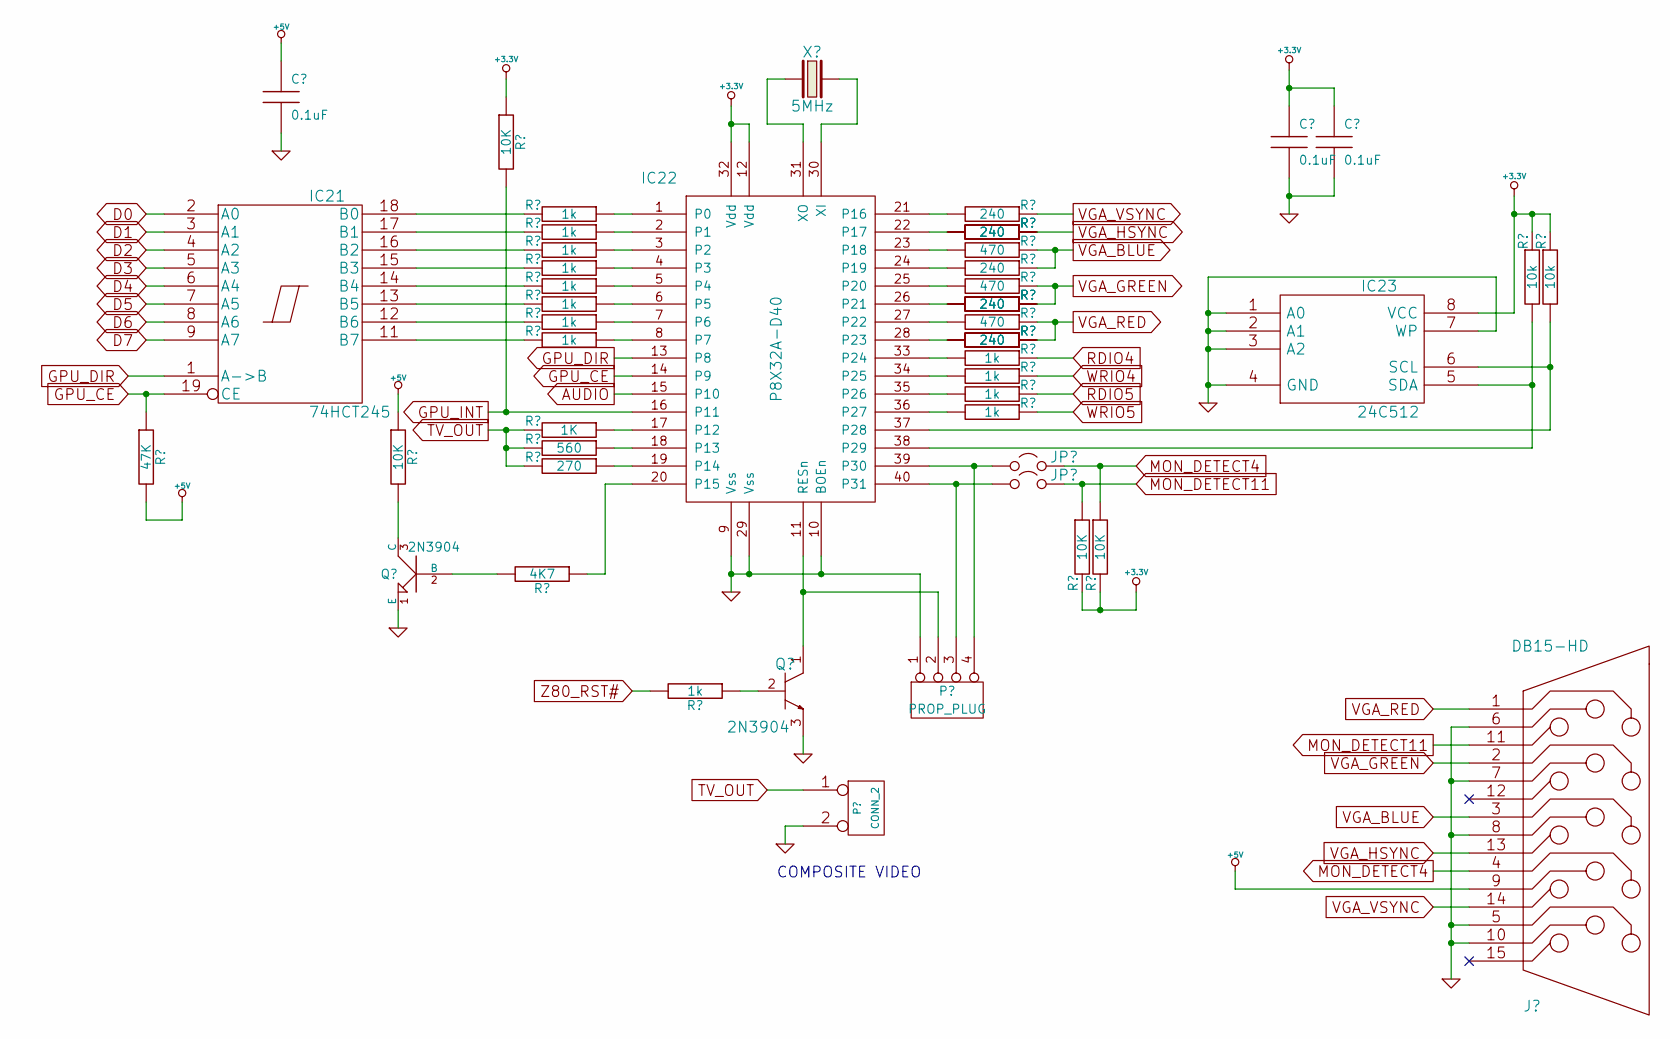
[picture p25: schematic videodriver.sch]

Parts:
IC21: 74HCT245; 108-5315
IC22: P8X32A-D40
IC23: 24C512; 136-2656

Connections:
+3.3V: IC22.12 (Vdd), IC22.32 (Vdd), IC23.8 (VCC)
AUDIO: IC22.15 (P10)
D0: IC21.2 (A0)
D1: IC21.3 (A1)
D2: IC21.4 (A2)
D3: IC21.5 (A3)
D4: IC21.6 (A4)
D5: IC21.7 (A5)
D6: IC21.8 (A6)
D7: IC21.9 (A7)
GND: IC22.9 (Vss), IC22.10 (BOEn), IC22.29 (Vss), IC23.1 (A0), IC23.2 (A1), IC23.3 (A2), IC23.4 (GND), IC23.7 (WP)
GPU_CE: IC21.19 (CE), IC22.14 (P9)
GPU_DIR: IC21.1 (A->B), IC22.13 (P8)
GPU_INT: IC22.16 (P11)
unnamed: IC22.37 (P28), IC23.6 (SCL)
unnamed: IC22.38 (P29), IC23.5 (SDA)

Notes on the sheet:
COMPOSITE VIDEO
