hairymnstr/Z80-Project-Mark-2/pic/rom.asm

list p=18f4520
#include <p18f4520.inc>

    org 0x6000

    data 0x60C3, 0x000E, 0x0000, 0x0000 ; 6000
    data 0x0000, 0x0000, 0x0000, 0x0000 ; 6008
    data 0x0000, 0x0000, 0x0000, 0x0000 ; 6010
    data 0x0000, 0x0000, 0x0000, 0x0000 ; 6018
    data 0x0000, 0x0000, 0x0000, 0x0000 ; 6020
    data 0x0000, 0x0000, 0x0000, 0x0000 ; 6028
    data 0x0000, 0x0000, 0x0000, 0x0000 ; 6030
    data 0xC5F5, 0xE5D5, 0x06DB, 0x47CB ; 6038
    data 0x62CA, 0xCB00, 0xCA4F, 0x004B ; 6040
    data 0x68C3, 0xDB00, 0x3203, 0x1872 ; 6048
    data 0x5232, 0x2102, 0x0252, 0x023E ; 6050
    data 0x0FCD, 0x3E02, 0xD320, 0xC305 ; 6058
    data 0x0068, 0x88CD, 0xC302, 0x0068 ; 6060
    data 0xD1E1, 0xF1C1, 0xEDFB, 0x004D ; 6068
    data 0x0000, 0x0000, 0x0000, 0x0000 ; 6070
    data 0x0000, 0x0000, 0x0000, 0x0000 ; 6078
    data 0x0000, 0x0000, 0x0000, 0x0000 ; 6080
    data 0x0000, 0x0000, 0x0000, 0x0000 ; 6088
    data 0x0000, 0x0000, 0x0000, 0x0000 ; 6090
    data 0x0000, 0x0000, 0x0000, 0x0000 ; 6098
    data 0x0000, 0x0000, 0x0000, 0x0000 ; 60A0
    data 0x0000, 0x0000, 0x0000, 0x0000 ; 60A8
    data 0x0000, 0x0000, 0x0000, 0x0000 ; 60B0
    data 0x0000, 0x0000, 0x0000, 0x0000 ; 60B8
    data 0x0000, 0x0000, 0x0000, 0x0000 ; 60C0
    data 0x0000, 0x0000, 0x0000, 0x0000 ; 60C8
    data 0x0000, 0x0000, 0x0000, 0x0000 ; 60D0
    data 0x0000, 0x0000, 0x0000, 0x0000 ; 60D8
    data 0x0000, 0x0000, 0x0000, 0x0000 ; 60E0
    data 0x0000, 0x0000, 0x0000, 0x0000 ; 60E8
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
    data 0x0000, 0x0000, 0x0000, 0x0000 ; 7F48
    data 0x0000, 0x0000, 0x0000, 0x0000 ; 7F50
    data 0x0000, 0x0000, 0x0000, 0x0000 ; 7F58
    data 0x0000, 0x0000, 0x0000, 0x0000 ; 7F60
    data 0x0000, 0x0000, 0x0000, 0x0000 ; 7F68
    data 0x0000, 0x0000, 0x0000, 0x0000 ; 7F70
    data 0x0000, 0x0000, 0x0000, 0x0000 ; 7F78
    data 0x0000, 0x0000, 0x0000, 0x0000 ; 7F80
    data 0x0000, 0x0000, 0x0000, 0x0000 ; 7F88
    data 0x0000, 0x0000, 0x0000, 0x0000 ; 7F90
    data 0x0000, 0x0000, 0x0000, 0x0000 ; 7F98
    data 0x0000, 0x0000, 0x0000, 0x0000 ; 7FA0
    data 0x0000, 0x0000, 0x0000, 0x0000 ; 7FA8
    data 0x0000, 0x0000, 0x0000, 0x0000 ; 7FB0
    data 0x0000, 0x0000, 0x0000, 0x0000 ; 7FB8
    data 0x0000, 0x0000, 0x0000, 0x0000 ; 7FC0
    data 0x0000, 0x0000, 0x0000, 0x0000 ; 7FC8
    data 0x0000, 0x0000, 0x0000, 0x0000 ; 7FD0
    data 0x0000, 0x0000, 0x0000, 0x0000 ; 7FD8
    data 0x0000, 0x0000, 0x0000, 0x0000 ; 7FE0
    data 0x0000, 0x0000, 0x0000, 0x0000 ; 7FE8
    data 0x0000, 0x0000, 0x0000, 0x0000 ; 7FF0
    data 0x0000, 0x0000, 0x0000, 0x0000 ; 7FF8

    end
