hairymnstr/Z80-Project-Mark-2/(commit log)

2010-03-22 Begun updating the documentation to current state
2010-03-30 Added the new memory addon schematics
    [memory_expansion.sch]
2010-12-17 Updated the schematics to current state.
    [RTC.sch, Z80.sch, interrupt.sch, iodecode.sch, keyboard.sch, master_pic.sch, memory.sch, psu.sch]
2011-03-02 Added new schematics and about to start coding for new MMU.
    [Memory2.sch, RTC.sch, Z80.sch, interrupt.sch, iodecode.sch, keyboard.sch, master_pic.sch, memory.sch]
2011-03-06 Updated the code and circuit diagrams for first boot from banked RAM.
    [Memory2.sch, RTC.sch, Z80.sch, interrupt.sch, iodecode.sch, keyboard.sch, master_pic.sch, memory.sch]
2011-03-14 More tidying up
    [memory_expansion.sch, uiboard.sch]
2011-03-17 Sorted out the pointer bugs I introduced moving stuff around for the new DMA SD card code. (I think they're fixed anyway)
    [host_bus.asm, serial.asm]
